unax4/Haptic-stimulation-and-drone-control/TFM_Guante_Haptico/main.tex

\documentclass[12pt]{article}
\usepackage[a4paper]{geometry}
\usepackage[dvipsnames]{xcolor}
\usepackage{lipsum}
\usepackage{framed}
\usepackage{graphicx}
\usepackage{afterpage}
\usepackage[spanish,es-nodecimaldot]{babel}
\usepackage[utf8]{inputenc}
\usepackage{titlesec}
\usepackage{colortbl}
\usepackage{xcolor}
\usepackage{cite}
\usepackage{booktabs}
\usepackage{tabularx}
\usepackage{enumerate}
\usepackage{multirow}
\usepackage{graphics}
\usepackage{appendix}
\usepackage{colortbl}
\definecolor{rowgray}{gray}{0.93}
\usepackage[nottoc]{tocbibind}
\addto\captionsspanish{
  \renewcommand{\refname}{Bibliografía}
}

\usepackage{tikz}
\usetikzlibrary{shapes,arrows}
\usepackage{caption}

\captionsetup{
  font=small,              % Tamaño pequeño, fuente LM Roman (por defecto)
  labelfont=bf,            % "Figura X." en negrita
  textfont=it,             % Descripción en cursiva (opcional)
  labelsep=period,         % Punto en lugar de dos puntos
  justification=centering,
  skip=0pt
}

\captionsetup[table]{
  name=Tabla,
  font=small,
  labelfont={bf},
  textfont=it,
  labelsep=period,
  justification=centering,
  position=top            % Captions de tablas arriba
}
\usepackage{subcaption}
\usepackage{amsmath,amsthm,amssymb,mathrsfs} 
\usepackage[final]{pdfpages}
\usepackage[]{placeins,flafter}
\usepackage[none]{hyphenat} \sloppy
\usepackage{xcolor}
\usepackage{adjustbox}
\geometry{top=2.5cm, bottom=2.5cm, left=2.5cm, right=2.5cm}
\usepackage[hidelinks]{hyperref}

% Configuramos el formato de la sección
\titleformat{\section}
  {\normalfont\Large\bfseries} % Estilo del texto
  {\thesection}                % Etiqueta (el número)
  {1em}                        % Espacio entre número y título
  {}                           % Código antes del título
  [{\titlerule[1.2pt]}]        % Código después: la línea (pegada al título)

\titlespacing*{\section}{0pt}{3.5ex plus 1ex minus .2ex}{2pc}

\newcommand{\sectionbreak}{\clearpage} % Requiere el paquete titlesec
\hypersetup{
    colorlinks=true,
    linkcolor=black,      % Color de enlaces internos
    citecolor=blue,       % Color de las citas ← AQUÍ
    filecolor=magenta,
    urlcolor=cyan,
}
\usepackage{chngcntr}
\counterwithin{figure}{section}
\counterwithin{table}{section}
\counterwithin{equation}{section}

\addto\captionsspanish{
  \renewcommand{\listfigurename}{Lista de Figuras}
  \renewcommand{\listtablename}{Lista de Tablas}
  \def\acknowledgmentsname{Agradecimientos}
}
% --- Configuración de Acrónimos ---
\usepackage[acronym, nomain, toc, section=section]{glossaries} 
\makeglossaries

% Definición acronimos
\newacronym{imu}{IMU}{Inertial Measurement Unit}
\newacronym{ble}{BLE}{Bluetooth Low Energy}
\newacronym{pcb}{PCB}{Printed Circuit Board}
\newacronym{tfg}{TFG}{Trabajo Fin de Grado}
\newacronym{adc}{ADC}{Analog to Digital Converter}
\newacronym{dac}{DAC}{Digital to Analog Converter}
\newacronym{lsb}{LSB}{Least Significant Byte}
\newacronym{udp}{UDP}{User Datagram Protocol}
\newacronym{spi}{SPI}{Serial Peripheral Interface}
\newacronym{sram}{SRAM}{Static Random-Access Memory}
\newacronym{fet}{FET}{Field-Effect Transistor}
\newacronym{bjt}{BJT}{Bipolar Junction Transistor}

\begin{document}
\definecolor{light-gray}{gray}{0.87}  

\begin{titlepage}

\vspace*{-4mm}
\begin{figure}[!h]
  \centering
	
\end{figure}

\vspace*{10mm}

\fontsize{28pt}{28pt}\selectfont
\begin{center}
\setlength{\fboxsep}{3.4mm}
\adjustbox{minipage=14.4cm,cfbox=black,center}{\begin{center} Trabajo Fin de Máster \end{center}}
\end{center}
\vspace*{5mm}

\fontsize{16pt}{16pt}\selectfont
\center{MASTER EN FÍSICA Y TECNOLOGÍAS FÍSICAS}

\vspace*{18.7mm}

\fontsize{20pt}{20pt}\selectfont
\begin{center}
\textbf{Sistema háptico basado en estimulación electrotáctil para captura de movimiento e interacción hombre-máquina }
\end{center}
\baselineskip 20pt

\vspace*{1cm} 
\baselineskip 36pt
\begin{center}
\fontsize{12pt}{12pt}\selectfont
\center{\rm  Autor}

\vspace*{1mm} 
\fontsize{18pt}{18pt}\selectfont
\center{Unax Arregi Ballestero}
\vspace*{1cm}
\baselineskip 36pt
\fontsize{12pt}{12pt}\selectfont
\center{\rm  Directores}
\vspace*{1mm}
\fontsize{14pt}{14pt}\selectfont
\center{Nicolás Medrado Marqués}
\center{Belén Calvo López}
\end{center}

\setcounter{footnote}{1}

\vspace*{26.45mm}
\fontsize{12pt}{12pt}\selectfont
\begin{center}
FACULTAD DE CIENCIAS\\
\vspace{3.5mm}
Departamento de Ingeniería Electronica y Comunicaciones\\
\vspace{3.5mm}
20 de Junio de 2026\\
\end{center}

\renewcommand{\thefootnote}{\arabic{footnote}}
\pagenumbering{gobble}
\end{titlepage}

\pagenumbering{roman}

\phantomsection
\addcontentsline{toc}{section}{\acknowledgmentsname}
\section*{\acknowledgmentsname} 

Gracias a la Agencia Estatal de Investigación, Ministerio de Ciencia e Innovación, con número de proyecto PID2022-138785OB-I00 (MCIN/AEI/10.13039/501100011033/FEDER, UE) por financiar los componentes necesarios para el desarrollo de este trabajo.

Asi mismo, gracias a mis directores del trabajo, Nicolás y Belén, por su apoyo, paciencia y guía durante todo el proceso de desarrollo de este trabajo. Y en especial, gracias a Oscar Lasarte por su indispensable ayuda en todo el montaje de la instrumentación y por todas las reparaciones que han sido necesarias a lo largo del proceso.

\listoffigures        % Índice de figuras
\listoftables         % Índice de tablas

\printglossary[type=\acronymtype, title={Lista de Acrónimos}]
\clearpage

%------------------ ÍNDICE ------------------
\newpage

\tableofcontents
\newpage

\pagenumbering{arabic}

%%%%%%%%%%%%%%%%%%%%%%%%%%%%%%%
%------------------ CONTENIDO ------------------
\section{Introducción}

La progresiva miniaturización de la electrónica y el aumento de la capacidad de procesamiento en sistemas embebidos han impulsado el desarrollo de nuevas formas de interacción entre humanos y dispositivos tecnológicos. En particular, las interfaces hápticas han cobrado especial relevancia en los últimos años, al permitir añadir el sentido del tacto como canal de comunicación con sistemas digitales, complementando los tradicionales estímulos visuales y auditivos. Esta tendencia resulta especialmente interesante en aplicaciones de realidad virtual, teleoperación y asistencia a la discapacidad.

Dentro de este marco, el presente Trabajo Fin de Máster se plantea como una continuación directa del Trabajo Fin de Grado llevado a cabo por Jorge Cuartero \cite{TFG}, en el que se abordó una primera aproximación al uso de sistemas vestibles para la captura del movimiento de la mano y su utilización como interfaz de control remoto mediante un \textit{dataglove}. A partir de esa base inicial, el objetivo actual consiste en avanzar hacia una integración más completa del sistema, incorporando un sistema háptico de estimulación electrotáctil y mejorando tanto el procesamiento embebido como la conectividad inalámbrica del dispositivo.

El núcleo del desarrollo se centra en construir un único guante vestible que sea capaz de combinar adquisición de movimiento, procesamiento local de datos y generación de sensaciones táctiles en la mano del usuario. Para ello se emplea un microcontrolador con capacidad de comunicación inalámbrica, una unidad de medida inercial (\gls{imu}) para la estimación de la orientación espacial y un sistema de estimulación eléctrica diseñado para generar sensaciones referidas en la zona palmar sin obstaculizar la manipulación natural de objetos. Así, se consigue mantener funcionalidad manual a la misma vez que se introduce un canal adicional de información sensorial.

El sistema resultante pretende servir como plataforma experimental para el estudio de interfaces hápticas portables y su aplicación a tareas de control e interacción virtual. La combinación de procesamiento embebido, adquisición sensorial y estimulación táctil en un único dispositivo portátil abre la puerta a interfaces más naturales, compactas y eficientes, donde parte del procesamiento se realiza localmente, reduciendo latencias y mejorando la autonomía del sistema.

A lo largo de la memoria, primeramente, se presenta el fundamento del sistema de estimulación electrotáctil y los criterios de diseño adoptados para lograr sensaciones localizadas en la mano. Después se describe el hardware del dispositivo, incluyendo el microcontrolador y demás electrónica necesaria. A continuación, se detalla el procesamiento de los datos de orientación y la integración de la información adquirida, junto con la caracterización experimental del sistema háptico. Finalmente, como aplicación del trabajo, se implementa el guante como un sustituto del mando de control de un dron, usando la comunicación inalámbrica brindada por el microcontrolador y empleando la parte háptica como un canal de información para conocer la telemetría del dron sin usar pantallas. Para concluir, se entabla una discusión de las limitaciones actuales y posibles líneas futuras de desarrollo.

\section{Generación de sensación táctil en la zona palmar de la mano}

Para poder crear sensación táctil en la mano, el objetivo es estimular los nervios que la atraviesan con una corriente determinada. Tanaka et al. \cite{Tanaka2023} diseñaron este sistema tratando de generar estas sensaciones en la zona palmar de la mano sin obstruir la misma, preservando así la destreza manual y la capacidad de interactuar con objetos físicos. Para lograrlo, se emplea una técnica basada en \textit{sensaciones referidas}, donde la estimulación eléctrica aplicada en una zona (el dorso de la mano) provoca percepciones somatosensoriales en una zona distal (la zona palmar).

A continuación, se describen los cinco desafíos técnicos identificados en la literatura analizada y las soluciones de diseño implementadas para alcanzar una estimulación precisa en 10 puntos de la zona palmar.

\paragraph{Desafío 1: Selección del punto de estimulación anatómica:} 

Aunque los nervios mediano y cubital recorren el antebrazo y la muñeca, la estimulación en estos puntos se ve limitada debido a que los nervios se encuentran agrupados o empaquetados. Esto impide la activación selectiva de dedos individuales sin generar interferencias entre ellos. 

Se optó por situar los electrodos en el dorso de la mano, ya que tras cruzar la muñeca, los nervios digitales se ramifican hacia cada dedo de forma independiente, haciendo posible un control individualizado de cada uno de ellos. Esta diferencia anatómica en la distribución de los nervios se ilustra en la Figura~\ref{fig:nervios_dorso}.

\paragraph{Desafío 2: Profundidad de penetración de la corriente}
Una disposición convencional de electrodos (ánodo y cátodo próximos sobre el dorso) resulta ineficaz, ya que la corriente fluye de forma superficial, estimulando solo los nervios dorsales. El principio físico aplicado aquí es que la profundidad de penetración de la corriente es proporcional a la distancia entre los electrodos. Para alcanzar los nervios palmares desde el dorso, se diseñó un sistema con una gran distancia inter-electrodo, permitiendo que la corriente atraviese de manera transversal el tejido de la mano. Esta elección de diseño se ilustra en la Figura~\ref{fig:nervios_dorso}.

\begin{figure}[htbp]
    \centering
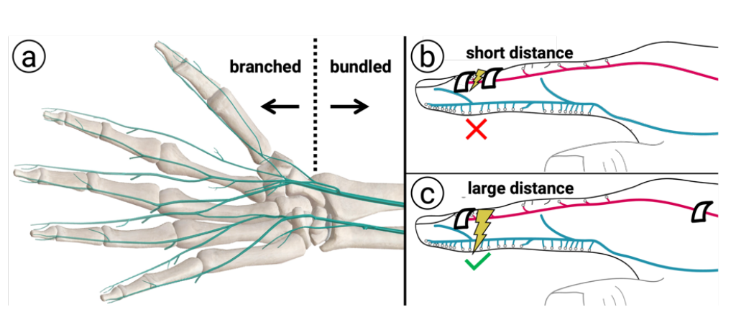
[picture p1: TFM_Guante_Haptico/Imagenes/nervios.png]
    
    \caption[Diferencia de agrupación nerviosa]{Ramificación en el dorso de la mano para la estimulación individual de dedos (a) y explicación esquemática de la elección de diseño de usar una distancia inter-electrodo grande (b y c). Adaptado de \cite{Tanaka2023}.}
    \label{fig:nervios_dorso}
\end{figure}

\paragraph{Desafío 3: Asimetría sensorial y umbrales de estimulación}
Según la teoría, la estimulación desde el dorso activa tanto la zona dorsal como la palmar, lo que generaría sensaciones confusas. Para resolver este conflicto, se aprovecha la diferencia entre número de neuronas que tienen las distintas partes de la mano: la zona palmar posee aproximadamente 18,000 mecanorreceptores, frente a solo 300 en la zona dorsal. 

Aprovechando esta diferencia, al calibrar la intensidad de la corriente, es posible superar el umbral de percepción palmar manteniéndose por debajo del umbral dorsal, haciendo que la sensación en la palma sea la única percibida por el usuario (ver Figura~\ref{fig:umbrales_sensibilidad}).

\paragraph{Desafío 4: Focalización de la sensación y polaridad}
Se observó que los electrodos situados en el dorso de los dedos generan sensaciones desplazadas (\textit{offset}) respecto a la ubicación deseada en la palma; específicamente, no lograban estimular las falanges distales. 

La solución implementada consistió en invertir la polaridad. Mientras que la estimulación anódica es el estándar, se implementó estimulación catódica para los electrodos de las falanges distales. Asi, se podría adelantar la ubicación de la sensación hacia la punta de los dedos, permitiendo la estimulación del pulpejo desde el dorso.

\begin{figure}[htbp]
    \centering
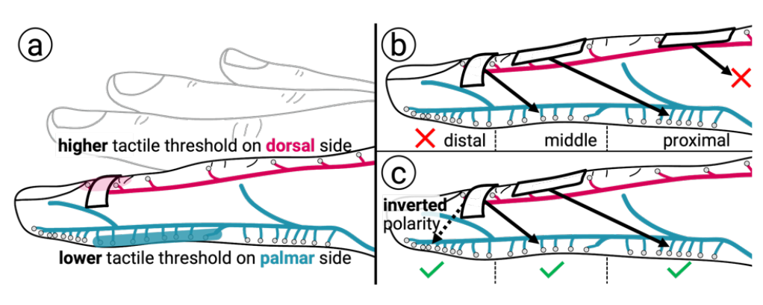
[picture p2: TFM_Guante_Haptico/Imagenes/umbrales.png]
    
    \caption[Asimetría de umbrales en la mano]{(a) El umbral táctil para la estimulación eléctrica es significativamente más bajo en el lado palmar que en el lado dorsal. (b, c) El uso de ambas polaridades (anódica y catódica) para el electrodo fijado a la punta del dedo permite la estimulación del pulpejo.}
    \label{fig:umbrales_sensibilidad}
\end{figure}

\paragraph{Desafío 5: Mitigación de interferencias inter-digitales}
Debido a que el nervio mediano inerva los dedos pulgar, índice y medio, mientras que el nervio cubital (ulnar) inerva el anular y meñique, el uso de un único electrodo de tierra general provocaba sensaciones referidas no deseadas en dedos adyacentes. 

El diseño final soluciona este problema mediante el uso de dos electrodos de tierra independientes, uno para cada nervio. Al conmutar el flujo de corriente hacia la tierra correspondiente según el dedo objetivo, se logra una selectividad total, resultando en un sistema capaz de generar sensaciones en un total de 10 electrodos colocados en la mano (más los dos de tierra) sin obstrucción palmar alguna, tal como se detalla en el esquema de la Figura~\ref{fig:disposicion_electrodos}.

\begin{figure}[htbp]
    \centering
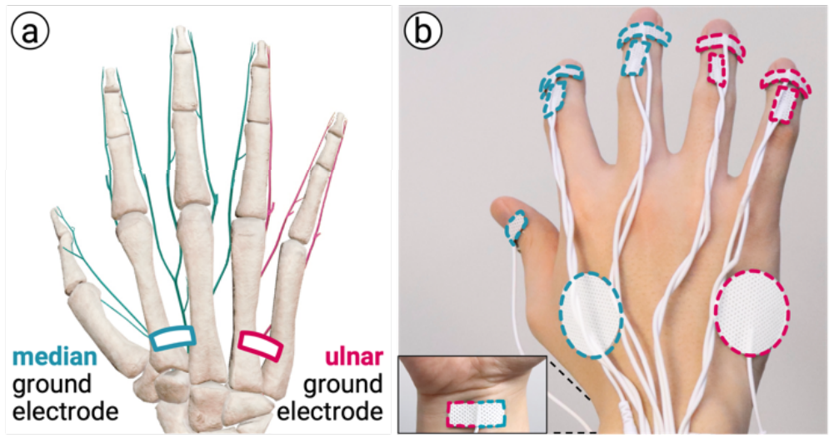
[picture p3: TFM_Guante_Haptico/Imagenes/disposicionfinal.png]
    
    \caption[Configuración final del sistema háptico]{Configuración final de electrodos con doble toma de tierra para evitar interferencias entre los nervios mediano y cubital. Adaptado de \cite{Tanaka2023}.}
    \label{fig:disposicion_electrodos}
\end{figure}

\section{Interfaz hardware}

El sistema completo para poder llevar a cabo el objetivo propuesto se monta en un guante, que se muestra en la Figura \ref{fig:montaje_completo}. Se distinguen los siguientes componentes: en cada dedo, del anular al meñique, sujetas por unas pequeñas piezas, fijamos bandas piezorresistivas que nos permitirán determinar su flexión. En la parte inferior se encuentra la \gls{pcb}, capaz generar corrientes controladas por voltaje y programadas mediante un potenciometro digital. En la parte inferior de la placa, se encuentran los conectores hembra donde se introducen los electrodos conectados a la mano. La información proporcionada por las bandas se introduce en un Raspberry RP2040 Connect, alojado en una caja central fijada a la muñeca. A la misma vez, este dispositivo se encarga de la generación de señales eléctricas que pasan por la \gls{pcb}.

\begin{figure}[htbp]
    \centering
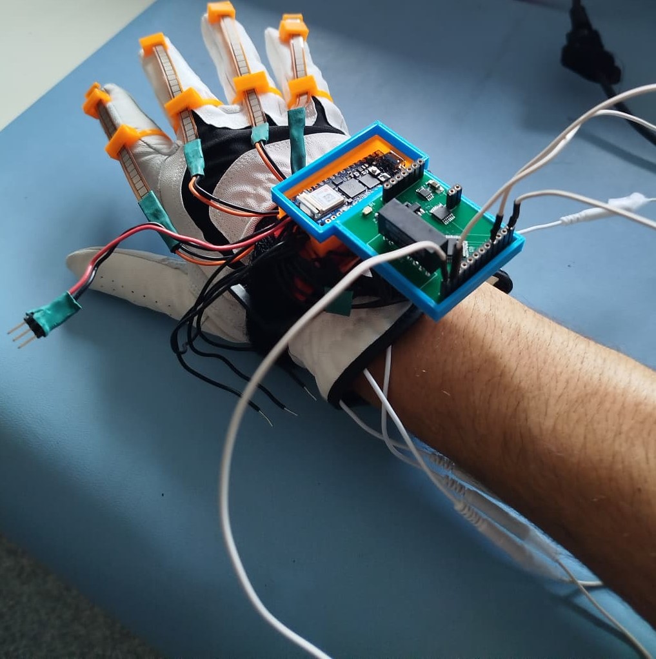
[picture p4: TFM_Guante_Haptico/Imagenes/montaje_completo.jpeg]
    
    \caption[Montaje final del sistema háptico]{Montaje final del sistema háptico y de captura de movimiento}
    \label{fig:montaje_completo}
\end{figure}

\subsection{Arduino Nano RP2040 Connect}
El microcontrolador usado para el trabajo será un módulo Arduino RP2040 Connect \cite{Arduino2040}, que incorpora un microcontrolador Raspberry Pi Pic. Este controlador proporciona una gran potencia de cálculo, un factor que será relevante en el procesamiento de datos que se llevará a cabo para la estimación de la orientación. Además tiene un modulo Wifi, que se usará para la comunicación en la interfaz de control en la sección \ref{sec:dron}.

En cuanto a las especificaciones generales, el RP2040 Connect opera a 3.3 V. Consta de un microcontrolador Raspberry Pi Pico (133 MHz de reloj, 256 kB de memoria \gls{sram}) con 8 entradas analógicas (configuradas como convertidores analógico-digitales o  \gls{adc}, de las que 4 estarían destinadas a la adquisición de las posiciones de los dedos. Cuenta además con una \gls{imu} de 6 ejes, modelo LSM6DSOXTR \cite{LSM6DSOX}.
\

\subsubsection{Módulo LSM6DSOXTR}

Este módulo \cite{LSM6DSOX} consta de un acelerómetro y un giróscopo, proporcionando así información de 6 ejes (3 de aceleración y 3 de rotación espacial). Aunque ambos pueden operar a distintos fondos de escala y resoluciones, la librería utilizada (Arduino\_LSM6DSOX \cite{LibreriaLSM6DSOX}) viene configurada con una sensibilidad de 0.122 mg/LSB (siendo g la aceleración de la gravedad y \gls{lsb} el bit menos significativo) para el acelerómetro y una sensibilidad de 0.07 dps/LSB para el giróscopo (donde dps son Degrees per second, grados por segundo), valores adecuados para nuestra aplicación
(menores que el propio ruido). Esta librería dispone de dos funciones, una encargada de devolver 3 valores en representación de punto flotante para los tres ejes de la aceleración, y la otra de devolver los 3 valores referentes a la velocidad de rotación en cada eje en el mismo formato.

La frecuencia de medida está fijada en 104 Hz de manera predeterminada por la librería LSM6DSOX. Aunque una alta frecuencia de muestreo era importante para la estimación de la orientación mediante integración del giroscopio \cite{TFG}, para el método que se utilizará en este trabajo con esta tasa de muestreo se obtendrá un resultado que no se verá limitado por este valor. De todos modos, con esta configuración un ciclo de medida y procesado de nuestro Arduino no podrá durar más de 10  para que no se solapen medidas de la \gls{imu}, forzando a optimizar los tiempos de cada parte del procesado.

\subsubsection{Módulo de conectividad inalámbrica NINA-W102}

La comunicación inalámbrica del guante se implementa a través del módulo u-blox NINA-W102 \cite{NINA-W102}, integrado directamente en la placa Arduino Nano RP2040 Connect. Su arquitectura interna aloja un microprocesador de doble núcleo ESP32 dedicado en exclusiva a la gestión de la pila de protocolos de red, lo que descarga completamente al procesador principal RP2040 de esta tarea y preserva su capacidad de cómputo para el procesamiento de la \gls{imu}, la lógica de control y el sistema háptico.

El módulo soporta tanto \gls{ble} como Wi-Fi (802.11 b/g/n a 2.4~GHz). Para este diseño se ha optado por Wi-Fi, ya que el volumen de datos a transmitir y el procesamiento extra del sistema, exige un ancho de banda que \gls{ble} no puede garantizar sin introducir retardos en el lazo de control con el entorno virtual, a parte de qué usar Wi-Fi será imprescindible debido a las caracteristicas del dron que se operará en la sección \ref{sec:dron}.

\subsection{Sistema de adquisición de posiciones de la mano}
El sistema de determinación de la flexión de los dedos se basa en las bandas piezorresistivas antes mencionadas. Una piezorresistencia es un material o componente que, bajo un esfuerzo mecánico, sufre un cambio en su resistividad. En nuestro caso se usarán los Flex Sensor de Spectra Symbol \cite{Flex-Sensor}, caracterizados por valores nominales entre $7\,\mathrm{k\Omega}$ y $13\,\mathrm{k\Omega}$ en reposo, de forma que al ser dobladas, como mínimo duplican su valor resistivo. Como el Arduino no puede medir directamente resistencias, en \cite{TFG} se implementó un circuito auxiliar que permite traducir estos cambios en tensión.

Este circuito consiste en un divisor resistivo formado por una resistencia fija ($R_{\text{fija}}$) en serie con el elemento piezorresistivo ($R_{\text{piezo}}$), alimentado a los 3.3~V proporcionados por el propio microcontrolador. De este modo, las variaciones de resistencia de los sensores se transforman en variaciones de voltaje según la relación:

\begin{equation}
V_{\text{divisor}}(R_{\text{piezo}}) = 3.3 \cdot \frac{R_{\text{fija}}}{R_{\text{piezo}} + R_{\text{fija}}}
\end{equation}

Para maximizar el rango de oscilación de la tensión de salida y optimizar la precisión de la lectura, el valor de $R_{\text{fija}}$ se calcula para cada sensor mediante la media geométrica de sus extremos resistivos:

\begin{equation}
R_{\text{fija}} = \sqrt{R_{\text{max}} \cdot R_{\text{min}}}
\end{equation}

donde $R_{\text{max}}$ y $R_{\text{min}}$ representan las resistencias máxima y mínima medidas en flexión (pico) y extensión (relajado), respectivamente. En el montaje real, se seleccionan los valores comerciales de resistencia fija más cercanos a los óptimos teóricos calculados para el rango de cada dedo. El cálculo con los valores que finalmente se usan en el \textit{dataglove} se detallan en el anexo de \cite{TFG}.

La tensión de salida del divisor se introduce en los pines analógicos del microcontrolador, configurados como entradas del \gls{adc}. Este convertidor opera con una resolución de 10 bits (lo que genera un rango digital de 0 a 1023 cuentas) y un rango de tensión de 0 a 3.3~V, lo que resulta en una resolución de medida de 3.2~mV. Además, el tiempo de adquisición es inferior a 30~$\mu$s, lo que cumple holgadamente con los requisitos de velocidad y tasa de muestreo exigidos para completar un ciclo de nuestro proceso.

\subsection{Circuito de estimulación electrotáctil}

Para poder conseguir estimular los nervios de la mano y generar sensación táctil, según la bibliografía existente en el ámbito \cite{Tanaka2023}, la corriente generada debe ser del orden de pocos miliamperios y, al mismo tiempo, de suficiente tensión como para superar la impedancia de la piel, que según medidas rápidas tomadas en el laboratorio esta en torno al megaohmio. 

Además, según el sistema de electrodos descrito en la sección 2, debe poder conmutar entre 10 canales de estimulación y cambiar entre corriente catódica y anódica según lo requiera la configuración correspondiente, por lo que teniendo todo esto en cuenta el circuito finalmente construido será el de la Figura \ref{fig:circuito_estimulacion}:

\begin{figure}[htbp]
    \centering
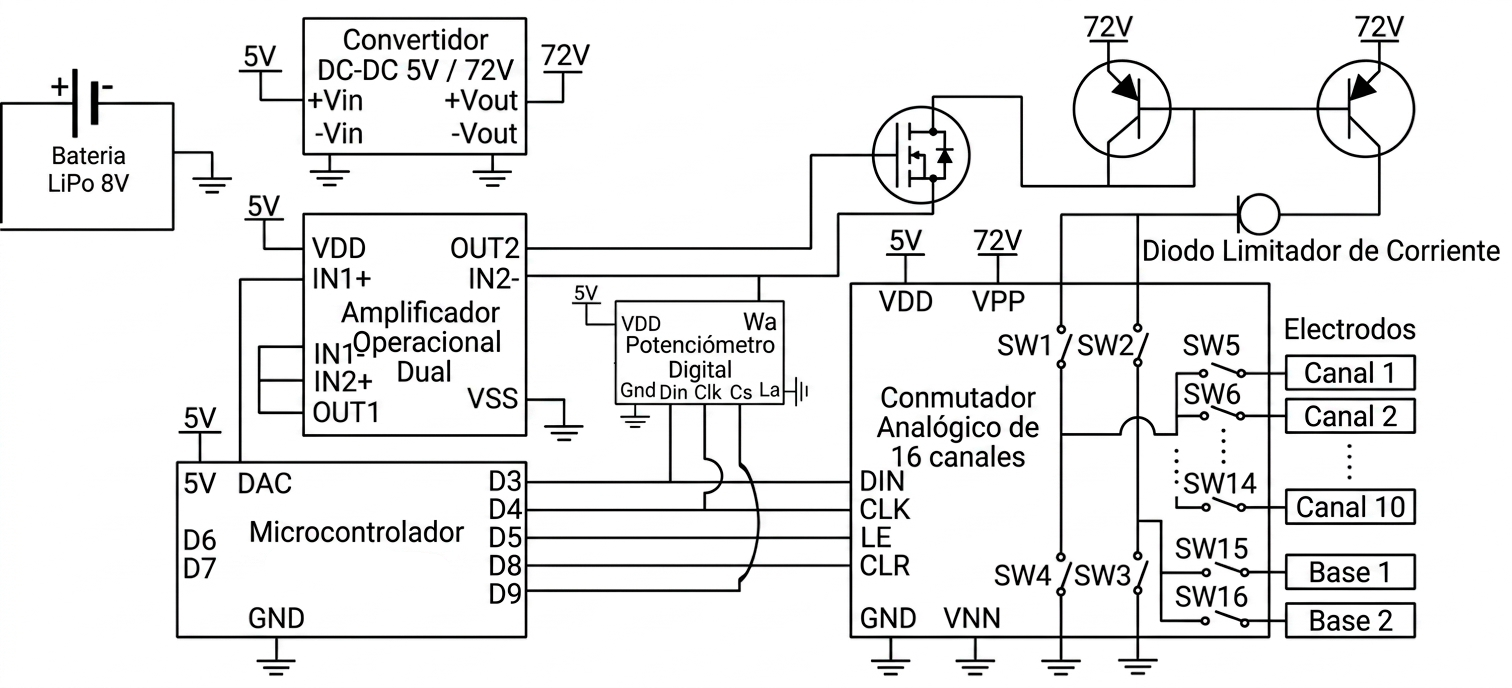
[picture p5: TFM_Guante_Haptico/Imagenes/Circuito_estimulacion.png]
     % Ajusta el nombre y escala
    \caption{Esquema del circuito de estimulación electrotáctil diseñado para el guante.}
    \label{fig:circuito_estimulacion}
\end{figure}

Así, este circuito se alimenta directamente a través de la batería de 7.4~V con una capacidad de almacenamiento de energía de 1000 mAh conectada al pin $V_{\text{in}}$ del Arduino Nano RP2040 Connect, colocando en el cable que sale a alimentar el sistema un regulador a 5 V constantes. Para la etapa de estimulación, la generación de la alta tensión de 72~V se confía a un convertidor DC-DC modelo NMT0572SC, el cual se alimenta con esta salida regulada de 5~V.

Como este microcontrolador no tiene una salida \gls{dac}, para controlar de manera precisa la intensidad de los impulsos electrotáctiles y adaptarla a los umbrales sensitivos del usuario, se ha sustituido el potenciómetro analógico manual por un potenciómetro digital MAX5413. El microcontrolador gobierna este dispositivo mediante un protocolo basado en \gls{spi}, optimizando el uso de pines al compartir las líneas de datos DIN y de reloj CLK con el circuito integrado de conmutación de alta tensión HV2701, requiriendo únicamente una línea adicional para la selección de chip el potenciometro (CS*). La señal digital del microcontrolador se hace pasar por este potenciómetro y se introduce en un amplificador operacional LMV341 conectado a un \gls{fet} BSS87, configurando una fuente de corriente controlada por voltaje para independizar la señal de la carga. Acto seguido, un espejo de corriente basado en transistores bipolares \gls{bjt} FCX705 replica esta corriente de referencia y la transfiere hacia la línea de alta tensión de 72~V, asegurando un flujo eléctrico constante.

La señal de corriente regulada por esta etapa se inyecta en el conmutador analógico de alta tensión HV2701. Este circuito integrado multiplexa la señal hacia los 10 canales disponibles en la mano y las dos tomas de tierra independientes (Base 1 y Base 2), encargadas de aislar los nervios mediano y cubital. Internamente, una matriz de interruptores actúa a modo de puente en H para invertir dinámicamente la polaridad de la estimulación (catódica o anódica) según los requerimientos específicos de la zona palmar seleccionada.

Debido a la arquitectura del sistema, el integrado HV2701 solo puede habilitar un camino de corriente hacia un único objetivo simultáneamente. Por ello, la simultaneidad perceptiva no se implementa manteniendo varios caminos activos a la vez, sino serializando los pulsos en el firmware: cada estímulo se aplica sobre una única ruta, que se abre y se cierra explícitamente antes de pasar a la siguiente. Dado que este integrado es capaz de conmutar entre canales en un tiempo de apenas 10~$\mu$s \cite{HV2701_DataSheet}, esta secuenciación cabe holgadamente dentro del tiempo de bucle de 10~ms.

Para dotar de seguridad al sistema y evitar accidentes se integra en serie un diodo limitador de corriente (E-452) que actúa como limitador físico si la corriente de salida llega a alcanzar los 4.5~mA, garantizando la inocuidad del guante ante cualquier fallo de ejecución en el microcontrolador. Por último, todo este diseño electrónico se ha plasmado en una \gls{pcb} que fue diseñada mediante el software KiCad y posteriormente enviada a fabricar para su ensamblaje final, diseño y resultado que se pueden ver en la Figura \ref{fig:diseno_pcb}.

\begin{figure}[htbp]
    \centering
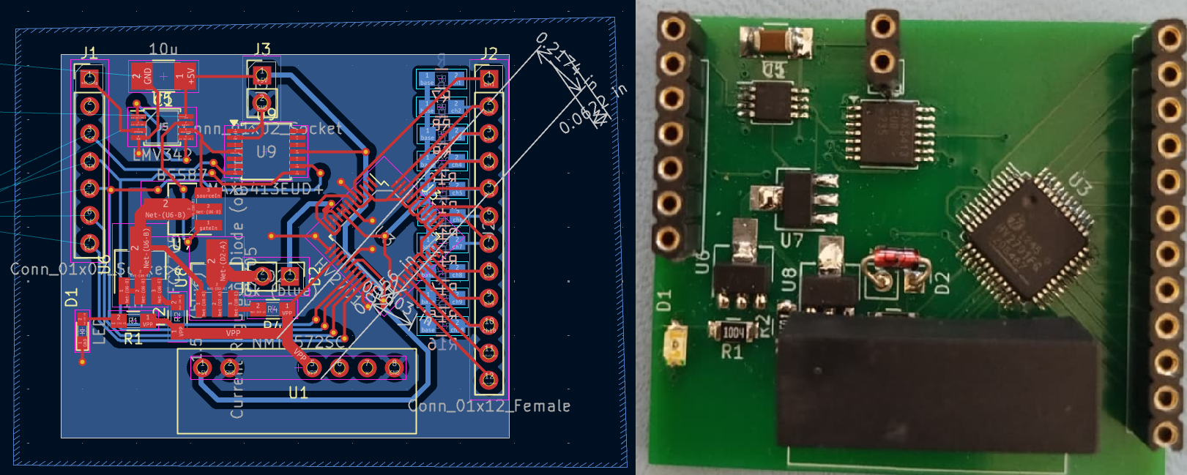
[picture p6: TFM_Guante_Haptico/Imagenes/diseño_pcb.png]
     % Ajusta el nombre de la imagen y escala
    \caption[Diseño final de la \gls{pcb} del circuito de estimulación electrotáctil]{Diseño final de la \gls{pcb} del circuito de estimulación electrotáctil desarrollado en KiCad y resultado final una vez se recibió de la fábrica. Agradecimientos a Diego Antolín por su ayuda con el diseño y a Óscar Lasarte por montar la placa.}
    \label{fig:diseno_pcb}
\end{figure}

\section{Procesamiento de datos: orientación espacial}
El núcleo del procesamiento de datos de la \gls{imu} LSM6DSOXTR reside en la estimación precisa de la orientación del sensor. Anteriormente, se planteaba el sistema de ecuaciones para obtener la expresión de los ángulos de Euler de la orientación, pero haciendo esto, una de las ecuaciones debe de integrar en el tiempo dos de los ejes del giroscopio. Con este método el procesamiento inducia en deriva de uno de los ángulos de manera inevitable \cite{TFG}.

Para este trabajo, se ha implementado un filtro algoritmico propuesto por Mahony et al. \cite{Mahony2008}, el cual formula el problema de estimación como una cinemática de observador determinista directamente sobre el grupo ortogonal especial $SO(3)$. Este método utiliza la geometría del grupo de Lie para desacoplar las mediciones del giroscopio del error de actitud reconstruido, buscando una implementación lo más eficiente posible para el hardware disponible.

\subsection{Representación de la orientación: cuaterniones}

Antes de formular el filtro, es necesario elegir cómo representar matemáticamente la orientación del sensor en el espacio tridimensional. La opción más intuitiva son los ya mencionados ángulos de Euler: guiñada $\psi$ (\textit{yaw}), cabeceo $\theta$ (\textit{pitch}) y alabeo $\phi$ (\textit{roll}). Estos presentan una singularidad
conocida como \textit{gimbal lock} cuando dos ejes de rotación se alinean, además de requerir funciones trigonométricas computacionalmente costosas para el RP2040.
Por ello, el filtro opera internamente con cuaterniones unitarios, una representación algebraica que evita estas singularidades y permite actualizar la orientación mediante operaciones aritméticas simples.

Un cuaternión unitario $\mathbf{q}$ queda definido como:

\begin{equation}
\mathbf{q} =
\begin{pmatrix}
q_0 \\ q_1 \\ q_2 \\ q_3
\end{pmatrix},
\qquad \|\mathbf{q}\|=1,
\end{equation}

donde $q_0$ es la parte escalar, asociada al ángulo de rotación, y
$(q_1, q_2, q_3)$ es la parte vectorial, asociada al eje de rotación. La condición de unitariedad garantiza que el cuaternión represente siempre una rotación pura, sin escalado. Cuando se requiere expresar la orientación final en ángulos de Euler para enviarlos al entorno de control, la conversión se realiza a posteriori, de forma que todo el procesamiento interno permanece libre de singularidades.

\subsection{Fusión de acelerómetro y giroscopio}

El giroscopio proporciona la velocidad angular $\boldsymbol{\omega}$, que integrada en el tiempo permite seguir la evolución de la orientación con gran precisión a corto plazo.
Sin embargo, cualquier sesgo (\textit{bias}) estático o deriva lenta en sus lecturas se acumula en la integral, generando un error de orientación que crece sin límite con el tiempo. El acelerómetro, por su parte, mide la aceleración total del sensor; cuando el guante no está sometido a aceleraciones externas apreciables, esta medida queda dominada por la gravedad terrestre, cuya dirección es conocida en el marco inercial. Esto permite obtener una referencia absoluta de inclinación, libre de deriva, aunque ruidosa en presencia de movimientos bruscos.

El filtro de Mahony se basa en la complementariedad de ambos sensores: el giroscopio proporciona una estimación dinámica y precisa a corto plazo, mientras que el acelerómetro corrige continuamente la deriva a largo plazo. Para cuantificar cuánto difiere la orientación estimada de la real se define un error vectorial $\mathbf{e}$ mediante el producto vectorial entre la dirección de la gravedad medida por el acelerómetro normalizada y la dirección de la gravedad que el cuaternión actual predice en el marco del sensor \cite{Mahony2008}:

\begin{equation}
\mathbf{e} = \hat{\mathbf{a}} \times \mathbf{v},
\end{equation}

donde $\hat{\mathbf{a}} = \mathbf{a}/\|\mathbf{a}\|$ es la aceleración normalizada y $\mathbf{v}$ es la estimación de la dirección de la gravedad obtenida rotando el vector $[0,0,1]^T$ con el cuaternión actual:

\begin{equation}
\mathbf{v} =
\begin{pmatrix}
2(q_1 q_3 - q_0 q_2) \\
2(q_0 q_1 + q_2 q_3) \\
q_0^2 - q_1^2 - q_2^2 + q_3^2
\end{pmatrix}.
\end{equation}

El producto vectorial produce un vector cuya dirección es el eje en torno al cual debe corregirse la estimación y cuya magnitud es proporcional al ángulo de error. Cuando ambos vectores coinciden, el error es nulo y el filtro no introduce ninguna corrección. Por lo tanto, esta formulación evita la reconstrucción algebraica completa de la actitud, ya que el error se calcula directamente en el espacio del sensor sin pasar por ángulos de Euler.

\subsection{Controlador PI y corrección del bias}

El error $\mathbf{e}$ se utiliza para corregir la velocidad angular antes de integrarla, mediante un controlador proporcional-integral (PI) clásico. La acción proporcional, escalada por la ganancia $K_p$, reacciona inmediatamente al error presente; la acción integral, escalada por $K_i$, acumula el error a lo largo del tiempo y compensa el sesgo estático del giroscopio:

\begin{equation}
\mathbf{e}_{\text{int}}(t) = \mathbf{e}_{\text{int}}(t - \Delta t) + K_i \, \mathbf{e} \, \Delta t,
\end{equation}

\begin{equation}
\boldsymbol{\omega}_c = \boldsymbol{\omega} + K_p \mathbf{e} + \mathbf{e}_{\text{int}}.
\end{equation}

La velocidad angular corregida $\boldsymbol{\omega}_c$ se usa para propagar el cuaternión en el tiempo. La cinemática diferencial del cuaternión unitario establece que:

\begin{equation}
\dot{\mathbf{q}} = \frac{1}{2} \, \mathbf{q} \otimes
\begin{pmatrix} 0 \\ \boldsymbol{\omega}_c \end{pmatrix},
\end{equation}

donde $\otimes$ denota el producto de cuaterniones. Discretizando mediante integración de Euler con paso $\Delta t$:

\begin{equation}
\mathbf{q}_{k+1} = \mathbf{q}_k + \frac{1}{2} \, \mathbf{q}_k \otimes
(0, \boldsymbol{\omega}_c) \, \Delta t,
\end{equation}

lo que, expandido en sus cuatro componentes, resulta en:

\begin{equation}
\begin{aligned}
q_0 &\leftarrow q_0 - \tfrac{\Delta t}{2}(q_1 g_x + q_2 g_y + q_3 g_z), \\
q_1 &\leftarrow q_1 + \tfrac{\Delta t}{2}(q_0 g_x + q_2 g_z - q_3 g_y), \\
q_2 &\leftarrow q_2 + \tfrac{\Delta t}{2}(q_0 g_y - q_1 g_z + q_3 g_x), \\
q_3 &\leftarrow q_3 + \tfrac{\Delta t}{2}(q_0 g_z + q_1 g_y - q_2 g_x),
\end{aligned}
\end{equation}

donde $(g_x, g_y, g_z)$ son las componentes de $\boldsymbol{\omega}_c$. Estas operaciones son básicamente sumas y multiplicaciones de enteros en punto flotante, sin funciones trigonométricas, lo que hace al algoritmo sea adecuado para el RP2040. Tras cada iteración, el cuaternión se renormaliza para mantener la condición de unitariedad y evitar la acumulación de errores numéricos:

\begin{equation}
\mathbf{q} \leftarrow \frac{\mathbf{q}}{\|\mathbf{q}\|}.
\end{equation}

La estabilidad de este esquema de corrección fue demostrada por Mahony et al. \cite{Mahony2008} mediante un análisis de Lyapunov. Utilizando como función candidata la traza de la matriz de error de orientación y el módulo del bias estimado, se prueba que su derivada temporal es semidefinida negativa, lo que garantiza la convergencia
casi global del error de orientación a cero y del bias estimado hacia su valor real.

\subsection{Calibración inicial y recentrado dinámico}

Al encender el guante, antes de comenzar la estimación en régimen permanente, se realiza una fase de calibración en la que el sistema se mantiene en reposo durante la adquisición de $N = 100$ muestras de velocidad angular. El bias inicial del giroscopio se estima como la media de dichas muestras:

\begin{equation}
\mathbf{b}_\omega = \frac{1}{N} \sum_{i=1}^{N} \boldsymbol{\omega}_i,
\end{equation}

y a partir de ese instante, toda medida angular se corrige sustrayendo este valor antes de introducirlo en el filtro. Esta calibración reduce el error inicial del controlador
integral, acelerando la convergencia del filtro.

Además del sesgo del giroscopio, existe un segundo problema a tener en cuenta: la orientación física del guante en el momento de encendido puede ser arbitraria, lo que haría que la estimación de la orientación comenzara desde una postura diferente. Para resolverlo, una vez completada la calibración se captura el cuaternión resultante como referencia de postura neutra, calculando su conjugado:

\begin{equation}
\mathbf{q}_{\text{off}} = (q_0, -q_1, -q_2, -q_3).
\end{equation}

A partir de ese momento, la orientación transmitida al entorno de control no es $\mathbf{q}$ sino la orientación relativa al instante de referencia, obtenida mediante el producto:

\begin{equation}
\mathbf{q}_{\text{rel}} = \mathbf{q}_{\text{off}} \otimes \mathbf{q}.
\end{equation}

Este recentrado garantiza que el sistema arranque siempre en una postura neutra definida por el usuario, independientemente de la orientación física inicial del guante, simplificando la puesta en marcha y haciendo el dispositivo robusto frente a variaciones en la colocación del guante entre sesiones. Además, durante el uso del guante, el usuario puede accionar el reseteo de la referencia en cualquier momento, lo que permite adaptar dinámicamente el sistema a cambios en la postura del brazo o a la necesidad de reajustar la posición neutra durante una sesión prolongada.

\section{Procesamiento de datos: flexión de los dedos}

A diferencia del bloque anterior, orientado al tratamiento de los datos de la \gls{imu}, este apartado describe el procesamiento de la información procedente de los divisores piezorresistivos para la determinación de la posición de los dedos. Como se adelantó en la introducción, esta tarea se delega en un módulo de inteligencia artificial embebido, ya que aunque sería factible establecer umbrales fijos para cada posición, las herramientas actuales de despliegue de modelos neuronales sobre microcontroladores ofrecen soluciones más flexibles, robustas frente a la variabilidad entre sesiones y computacionalmente ligeras.

Una red neuronal es un conjunto de nodos interconectados que, al recibir una serie de valores de entrada, los transforma a través de sucesivas capas de procesamiento hasta producir una salida. El interés de estas redes reside en su capacidad de ajustar los pesos de sus conexiones durante un proceso de entrenamiento, en el que se le presentan ejemplos etiquetados y la red modifica iterativamente sus parámetros para minimizar el error entre su salida y la respuesta esperada. Para el reconocimiento de posiciones de la mano, se emplea una arquitectura \textit{fully connected}, en la que todos los nodos de una capa conectan con todos los nodos de la siguiente, tal como se ilustra en la Figura~\ref{fig:red_fc}.

\begin{figure}[htbp]
    \centering
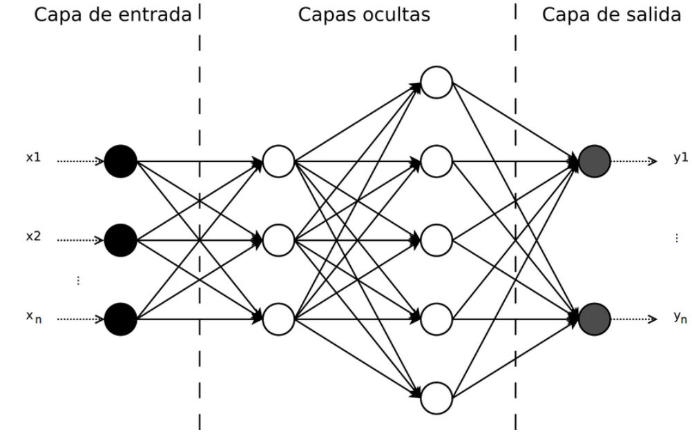
[picture p7: TFM_Guante_Haptico/Imagenes/fully_conected.png]
    
    \caption[Arquitectura de red neuronal \textit{fully connected}]{Esquema de una red
    neuronal \textit{fully connected} \cite{TFG}.}
    \label{fig:red_fc}
\end{figure}

La selección inicial de la arquitectura se lleva a cabo en Python mediante \textit{scikit-learn}, usando una red \textit{fully connected} de tipo \texttt{MLPClassifier}. Posteriormente, una vez fijada la configuración, el modelo equivalente se entrena y exporta con TensorFlow Lite \cite{TensorFlow} para su integración en el microcontrolador. Aun así, antes de definir la arquitectura de la red hay que recopilar una serie de datos que formarán el conjunto de entrenamiento.

\subsection{Dataset}

El \textit{dataset} es el conjunto de ejemplos etiquetados a partir del cual la red aprende a asociar cada combinación de lecturas sensoriales con la posición correcta de la mano. En este trabajo, las entradas de la red son los dos valores del \gls{adc} correspondientes a los dedos índice y corazón, únicos sensores piezorresistivos destinados al reconocimiento de postura. Los dedos anular y meñique se reservan para funciones de control independientes descritas en la sección~\ref{sec:dron}, por lo que sus lecturas no forman parte del clasificador.

La salida de la red es un identificador de posición codificado como un entero entre 0 y 8, correspondiente a las 9 posiciones representadas en la Figura~\ref{fig:posiciones_dataset}. Esta reducción respecto al trabajo previo, donde se usaban cuatro dedos \cite{TFG}, podría suponer una limitación, pero en ciertos aspectos aporta ventajas sobre la red neuronal: con solo dos entradas, el espacio de estados que la red debe aprender se reduce a la mitad, lo que permite alcanzar precisiones elevadas con arquitecturas más pequeñas, menor tiempo de inferencia en el microcontrolador y menor riesgo de sobreajuste durante el entrenamiento. Además, al disponer de un número de clases ligeramente menor (9 frente a 10), el problema de clasificación resulta intrínsecamente más sencillo, especialmente porque se eliminan algunas de las posiciones más similares entre sí que generan mayor confusión en la red.

\begin{figure}[htbp]
    \centering
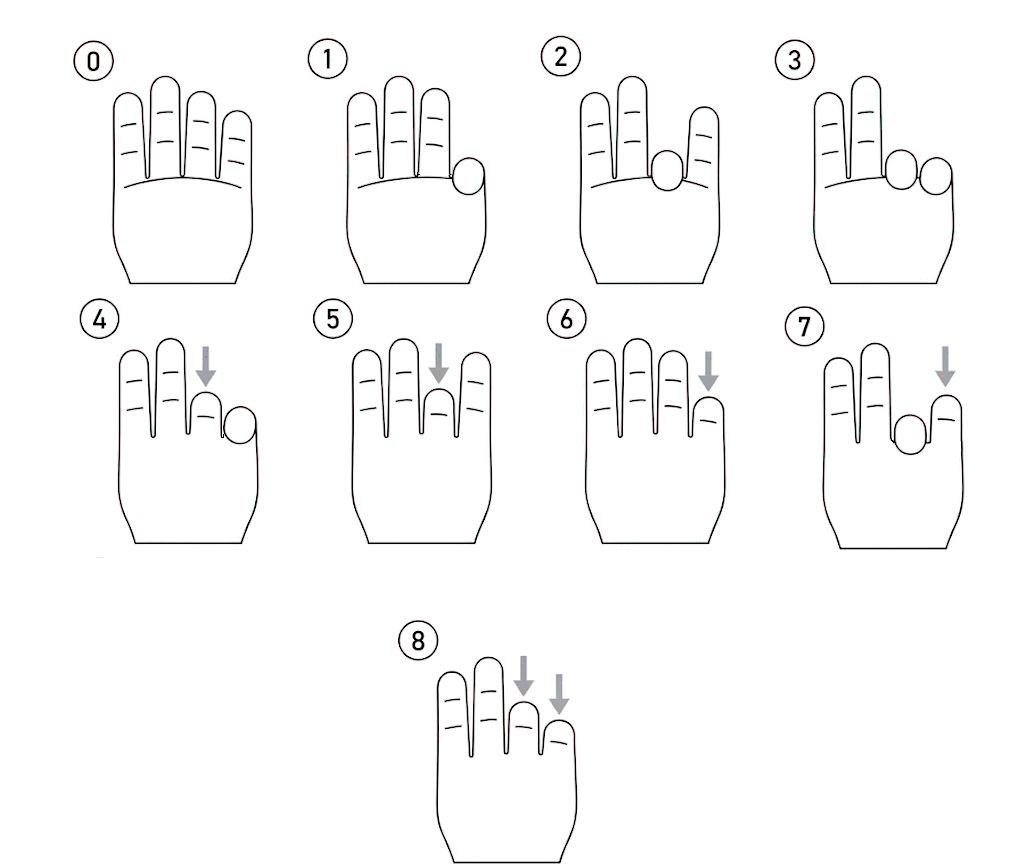
[picture p8: TFM_Guante_Haptico/Imagenes/DATASET.png]
    
    \caption[Posiciones definidas para el \textit{dataset}]{Representación de las 9
    posiciones definidas para el \textit{dataset}.}
    \label{fig:posiciones_dataset}
\end{figure}

Para la adquisición de los datos se desarrolló un programa que, cada vez que se pulsa \textit{enter}, solicita al usuario que adopte una de las posiciones indicadas y almacena las lecturas de los sensores en un fichero de texto. Con el fin de dotar a la red de la mayor robustez posible frente a variaciones en la colocación del guante o en las condiciones de uso, el \textit{dataset} se tomó a lo largo de varios días distintos, introduciendo así dispersión natural debida a ligeras diferencias en la posición del guante sobre la mano o en la postura del brazo.

El conjunto de datos resultante cuenta con 460 muestras, con entre 50 y 54 ejemplos por posición, distribuidas de forma uniforme entre las 9 clases para evitar sesgos durante el entrenamiento, como puede comprobarse en la Figura~\ref{fig:histograma_dataset}. En la Figura~\ref{fig:boxplot_dataset} se muestran los gráficos de cajas y bigotes para cada posición, que muestran la variabilidad de las lecturas del \gls{adc} en cada clase y la existencia de solapamientos entre algunas posiciones, lo que justifica la necesidad de un clasificador no lineal como la red neuronal para resolver estas ambigüedades.
En cuanto al reparto empleado durante la selección de la arquitectura, el 80\,\% de los datos se destinan al entrenamiento y validación cruzada, y el 20\,\% restante se reserva como conjunto de test, seleccionados de forma aleatoria estratificada.

\begin{figure}[htbp]
    \centering
    
    \caption[Distribución del \textit{dataset} por posición]{Histograma del número de
    muestras por posición en el \textit{dataset}.}
    \label{fig:histograma_dataset}
\end{figure}

\begin{figure}[htbp]
    \centering
    
    \caption[Distribución de valores ADC por posición]{Gráficos de cajas y bigotes que
    muestran la distribución de los valores del \gls{adc} para cada dedo en cada
    posición del \textit{dataset}.}
    \label{fig:boxplot_dataset}
\end{figure}

Por conveniencia, los valores del \textit{dataset} se escalan acotando todas las lecturas entre 0 y 1 respecto a los extremos registrados durante una calibración previa.
Esta normalización garantiza que, aunque existan ligeras variaciones en el funcionamiento de los sensores entre sesiones o diferencias en la colocación del guante, el clasificador opere siempre sobre el mismo rango de entrada, preservando su precisión
en el uso cotidiano.

\subsubsection{Codificación de salida}

Dado que se trata de un problema de clasificación multiclase, cada muestra del \textit{dataset} se etiqueta con un entero entre 0 y 8. Durante la selección de la arquitectura, el clasificador recibe directamente estas etiquetas numéricas y aprende a separar las nueve regiones del espacio formado por las dos lecturas de entrada. En el modelo exportado, la capa final mantiene 9 neuronas, una por posición, y la clase estimada se obtiene tomando la salida de mayor valor. De este modo se conserva una interfaz sencilla para el firmware, que solo necesita comparar las activaciones de salida para determinar la posición reconocida.

\subsection{Entrenamiento y selección de la arquitectura}

El objetivo del proceso de entrenamiento es encontrar la red de menor tamaño posible que mantenga una precisión lo más cercana posible al 100\,\%, ya que una red más compacta ocupa menos memoria en el microcontrolador y reduce el tiempo de inferencia, aspecto crítico dado el ciclo de 10\,ms impuesto por la tasa de muestreo de la \gls{imu}.

La red se construirá sobre una arquitectura de cuatro capas: una capa de entrada de 2 neuronas, dos capas ocultas de tamaño variable y una capa de salida de 9 neuronas. Para seleccionar la configuración se sigue el siguiente procedimiento: se separa un 20\,\% del conjunto como test y, sobre el 80\,\% restante, se realiza una búsqueda con validación cruzada estratificada de 5 particiones. Las arquitecturas candidatas son (40,20), (64,32), (128,64) y (128,128), combinadas con distintos valores de regularización \textit{L2} y tasa de aprendizaje inicial. La métrica optimizada es el \textit{F1-score}, más adecuada que la precisión global cuando se quiere equilibrar el rendimiento entre clases.

\begin{figure}[htbp]
    \centering
    
    \caption[Selección de la arquitectura mediante validación cruzada]{Mejor \textit{F1} obtenido en validación cruzada para cada arquitectura candidata durante la búsqueda en rejilla.}
    \label{fig:precision_vs_neuronas}
\end{figure}

El mejor resultado de validación cruzada se obtiene con dos capas ocultas de 40 y 20 neuronas, regularización \textit{L2} de $10^{-5}$ y tasa de aprendizaje inicial de $3\cdot10^{-3}$. Con esta configuración se alcanza un \textit{F1} medio de 0.983 durante la validación cruzada. Al evaluar el modelo seleccionado sobre el conjunto de test reservado, la precisión obtenida es 0.935 y el \textit{F1} es de 0.934, valores suficientes para el uso previsto teniendo en cuenta que el firmware añade una confirmación temporal de la posición predicha.

\subsection{Compresión e integración con TensorFlow Lite}

Una vez seleccionada la arquitectura, el modelo se exporta al microcontrolador mediante TensorFlow Lite \cite{TFLite} y su adaptación para Arduino, la librería Eloquent \cite{Eloquent}. Para el proceso de compresión primero se congelan todos los pesos de la red convirtiéndolos de variables a constantes y se elimina la arquitectura de entrenamiento, conservando únicamente la parte de inferencia; en segundo lugar, los parámetros se cuantifican de punto flotante de 32 bits a punto fijo de 8 bits, reduciendo el tamaño del modelo en memoria.

El resultado de la compresión es un fichero \texttt{.h} que se incorpora directamente al programa del Arduino. La arquitectura seleccionada, de tamaño 2--40--20--9, combina un número reducido de parámetros con una separación suficiente entre clases próximas, por lo que mantiene bajo el coste de inferencia sin comprometer el ciclo temporal del sistema. La arquitectura final y sus caracteristicas se resume en la Tabla~\ref{tab:arquitectura_red}.

\begin{table}[htbp]
\centering
\caption[Arquitectura final de la red neuronal]{Resumen de la arquitectura
de la red neuronal seleccionada tras el proceso de entrenamiento.}
\label{tab:arquitectura_red}

\begin{tabular}{lcc}
\hline
\textbf{Capa} & \textbf{Tamaño de salida} & \textbf{N.º de parámetros} \\
\hline
Entrada & 2 & -- \\
Densa 1 (ReLU) & 40 & 120 \\
Densa 2 (ReLU) & 20 & 820 \\
Salida (Softmax) & 9 & 189 \\
\hline
\textbf{Total} & -- & \textbf{1129} \\
\hline
\end{tabular}
\end{table}

Complementando al clasificador, se implementa un mecanismo de confirmación de posición: el sistema solo registra un cambio de estado cuando la red predice la nueva posición de forma consistente durante un intervalo de tiempo mínimo. Dado que el ciclo de medida es de 10\,ms, significativamente inferior al tiempo de reacción motora del usuario, sin este mecanismo las transiciones entre posiciones o los errores puntuales de la red generarían detecciones espurias que degradarían la experiencia de control.

\section{Estudio de percepción de sensación táctil}

Con el hardware completamente ensamblado y el firmware de control operativo, el siguiente paso antes de integrar el sistema en la aplicación final es caracterizar y validar experimentalmente el módulo de estimulación electrotáctil. Este apartado recoge, en primer lugar, la caracterización del circuito para establecer la relación entre la configuración del potenciómetro digital y la corriente realmente inyectada en los electrodos. A partir de dicha caracterización se obtiene una curva de linealización que permite programar directamente valores de corriente desde el microcontrolador. En segundo lugar, se describe un estudio perceptivo realizado sobre el propio autor con el objetivo de evaluar la capacidad del sistema para generar sensaciones táctiles localizadas en los puntos de la mano definidos en la sección~2.

\subsection{Caracterización de la curva de corriente}

El potenciómetro digital MAX5413 admite valores de configuración $\mathrm{P}$ comprendidos entre 0 y 255 bits, que el microcontrolador transmite mediante el protocolo \gls{spi}. Internamente, este dispositivo actúa como una resistencia variable en la red de polarización del amplificador operacional LMV342, de modo que el valor de $\mathrm{P}$ determina la resistencia efectiva $R(P)$ del potenciómetro según la relación:

\begin{equation}
    R(\mathrm{P}) = R_{\max} \cdot \frac{\mathrm{P}}{255},
\end{equation}

donde $R_{\max}$ es la resistencia máxima del dispositivo, en este caso $10~\mathrm{k}\Omega$. Dado que el amplificador operacional junto con el transistor \gls{fet} configura una fuente de corriente controlada por voltaje, la corriente de salida queda determinada por la tensión en el nodo de control, que a su vez es inversamente proporcional a $R(\mathrm{P})$. La corriente resultante sigue por tanto la relación:

\begin{equation}
    I \propto \frac{1}{\mathrm{P}},
    \label{eq:curva_corriente}
\end{equation}

Esta dependencia hiperbólica implica que incrementos iguales de $\mathrm{P}$ no producen incrementos iguales de corriente, siendo la respuesta muy sensible a valores bajos de $\mathrm{P}$ y
progresivamente más plana a medida que $\mathrm{P}$ aumenta.

Para verificar experimentalmente esta relación y cuantificar el valor de $K$, se conectó una resistencia de carga conocida $R_L=1004 ~\Omega$ entre los terminales de salida del circuito en lugar de los electrodos. Midiendo la tensión $V_L$ en bornes de la
resistencia con un multímetro, la corriente se obtiene directamente como $I = V_L / R_L$. El procedimiento se repitió para varios valores de $\mathrm{P}$ entre 0 y 255, programando cada configuración desde el Arduino y registrando la medida correspondiente. Los resultados obtenidos se muestran en la
Figura~\ref{fig:curva_IP}.

\begin{figure}[htbp]
    \centering
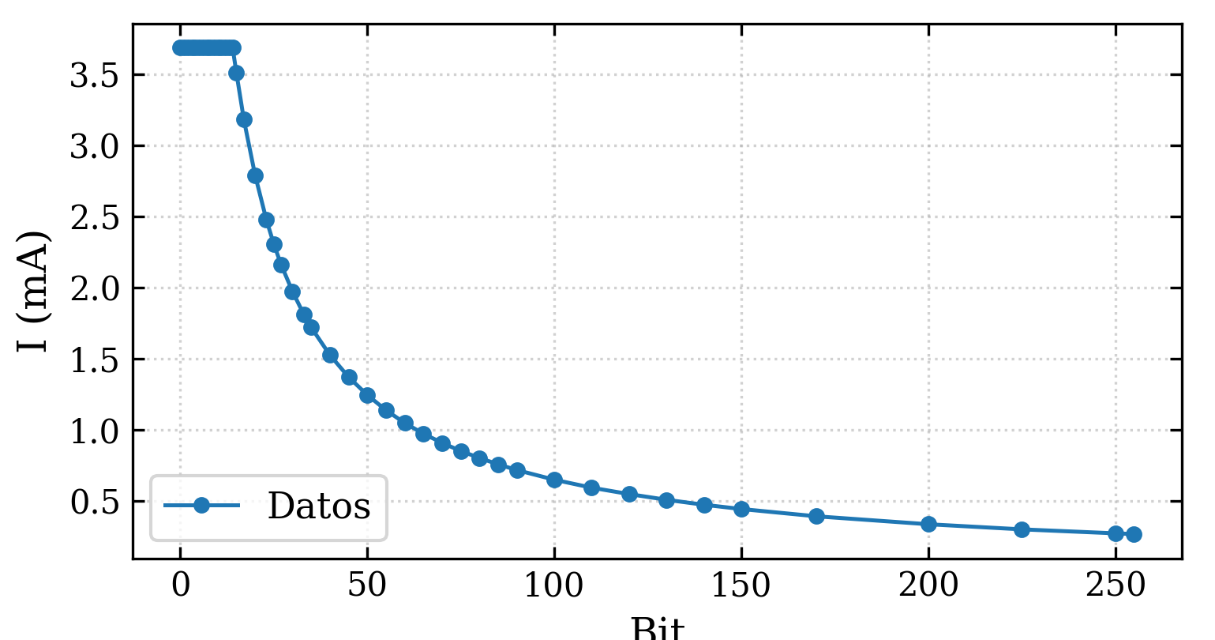
[picture p9: TFM_Guante_Haptico/Imagenes/curva_i_bit.png]
        
    \caption[Curva de corriente en función del valor del potenciómetro]{Corriente
    medida en la carga en función del valor de configuración $\mathrm{P}$ del potenciómetro
    digital. La curva presenta la forma hiperbólica $I \propto 1/P$ predicha, quitando la zona donde el diodo limitador de corriente empieza a tener efecto}
    \label{fig:curva_IP}
\end{figure}

\subsection{Linealización y regresión}

La relación hiperbólica de la ecuación~\eqref{eq:curva_corriente} resulta poco
conveniente para la caracterización del sistema, por lo que para obtener mediante una formula a que corriente corresponde cada valor de P, se procede a linealizar la curva mediante el cambio de variable $y = 1/I$, de modo que la relación entre corriente y variable transformada es lineal:

\begin{equation}
    y \propto  P
    \label{eq:linealizada}
\end{equation}

Sobre los datos experimentales transformados se realiza una regresión lineal por mínimos cuadrados, ajustando el modelo $y = a \cdot x + b$. Los parámetros del ajuste obtenidos son:

\begin{equation}
    \hat{a} = 0.01441 \, \qquad \hat{b} = 0.0824 \,
\end{equation}

con un coeficiente de determinación $R^2 = 0.9999$, lo que confirma la validez del modelo linealizado para describir el comportamiento del circuito en el rango de operación. Para el ajuste no se han tenido en cuenta los datos donde el diodo limitador de corriente tiene efecto. El ajuste se muestra superpuesto a los datos experimentales en la
Figura~\ref{fig:regresion}.

\begin{figure}[htbp]
    \centering
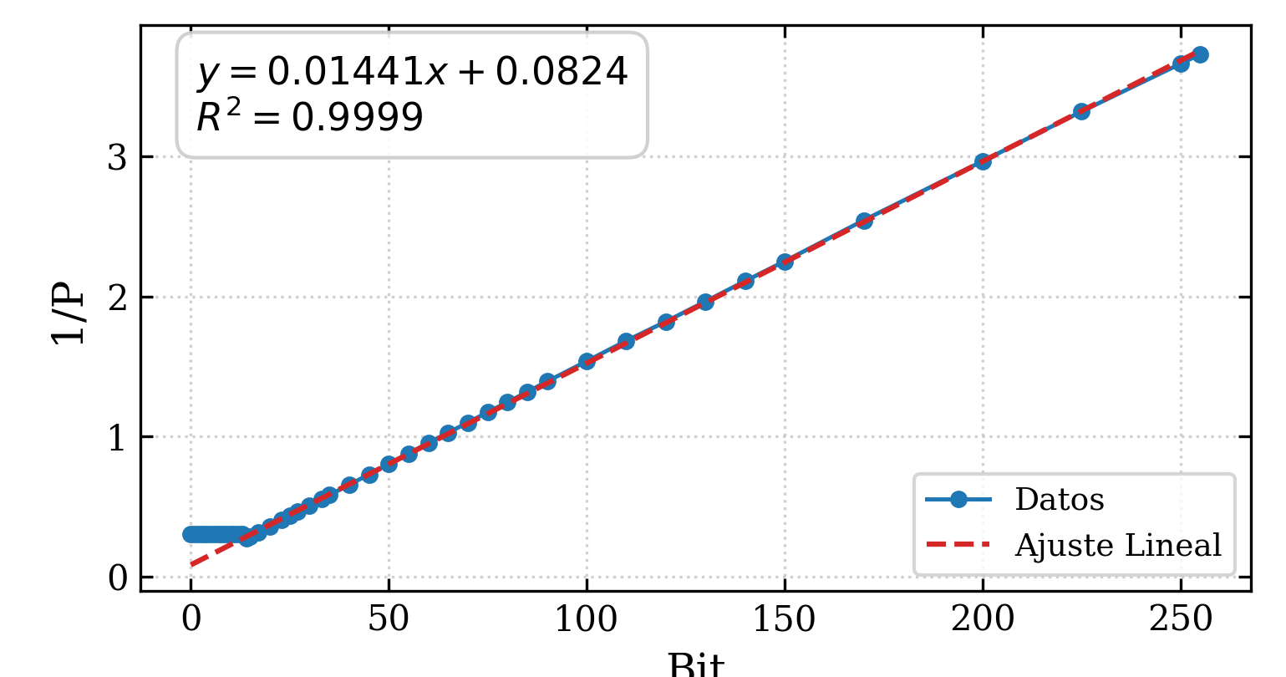
[picture p10: TFM_Guante_Haptico/Imagenes/curva_v_bit.png]
        
    \caption[Regresión lineal sobre la curva linealizada]{Corriente medida en función de $y$ junto con la recta de la regresión lineal. El elevado valor de $R^2$ confirma el comportamiento lineal tras el cambio de
    variable.}
    \label{fig:regresion}
\end{figure}

Por lo tanto, dado un valor de $\mathrm{P}$ el circuito dará una corriente de salida que seguirá la ecuación (\ref{eq:calibracion}):

\begin{equation}
    I(\mathrm{P})=\frac{1}{0,01441\cdot \mathrm{P}+0,0824}~mA
    \label{eq:calibracion}
\end{equation}

que se implementa en el firmware del Arduino para traducir cualquier valor de bit programado que se envía por \gls{spi} al MAX5413 con el valor de corriente correspondiente. De este modo, el resto del sistema opera en unidades de miliamperios, desacoplando la lógica de control de los detalles del circuito analógico.

Como se observa en las dos figuras, el diodo limitador E-452 integrado en serie garantiza que, ante cualquier combinación de parámetros, la corriente que entra en el multiplexador no supere los 4.5\,mA, por lo que la ecuación~\eqref{eq:calibracion} solo es válida en el rango $\mathrm{P} \in [15,\,255]$\,mA.
Los demás valores de $\mathrm{P}$ tendrán una corriente muy parecida a la que corresponde a $\mathrm{P}=15$.

\subsection{Estudio perceptivo}

Con el circuito caracterizado, se procede a validar el sistema
háptico mediante un estudio de percepción que se realizará sobre el propio autor. El objetivo será comprobar mediante un estudio rápido cuáles de los diez canales de estimulación, y con que polarización, son capaces de generar una sensación referida a la zona palmar esperada, descartando aquellos en los que la localización o la sensación no sea la correcta. Para ver los resultados conseguidos por un sistema similar pero con un número mayor de pacientes, se puede consultar la referencia \cite{Tanaka2023}.

\subsubsection{Protocolo experimental}

Para el estudio se emplea la señal \textit{Burst}, un pulso cuadrado de 50\,ms en estado activo, que produce una sensación puntual comparable a la de pulsar un botón. Para cada canal, se parte de un valor de $\mathrm{P}$ elevado, correspondiente a una corriente baja, y se va reduciendo progresivamente hasta que el autor detecta alguna sensación. En ese punto, se envian 5 pulsos consecutivos y se anota la zona de la mano en la que se ha percibido el estímulo. Si la zona indicada coincide con la zona palmar esperada para ese canal según el diseño de la sección~2, el canal se considera válido; en caso contrario, se descarta.

\subsubsection{Resultados}

La Tabla~\ref{tab:umbrales} recoge, para cada canal, la zona palmar objetivo, la polaridad de estimulación y el resultado del estudio. La Figura a la izquierda de la tabla muestra la correspondencia entre cada canal y su zona palmar asociada.
\newpage
\begin{table}[htbp]
    \centering
    \renewcommand{\arraystretch}{1.2}
    
    % --- COLUMNA IZQUIERDA: IMAGEN (a) ---
    \begin{minipage}[b]{0.42\textwidth}
        \centering
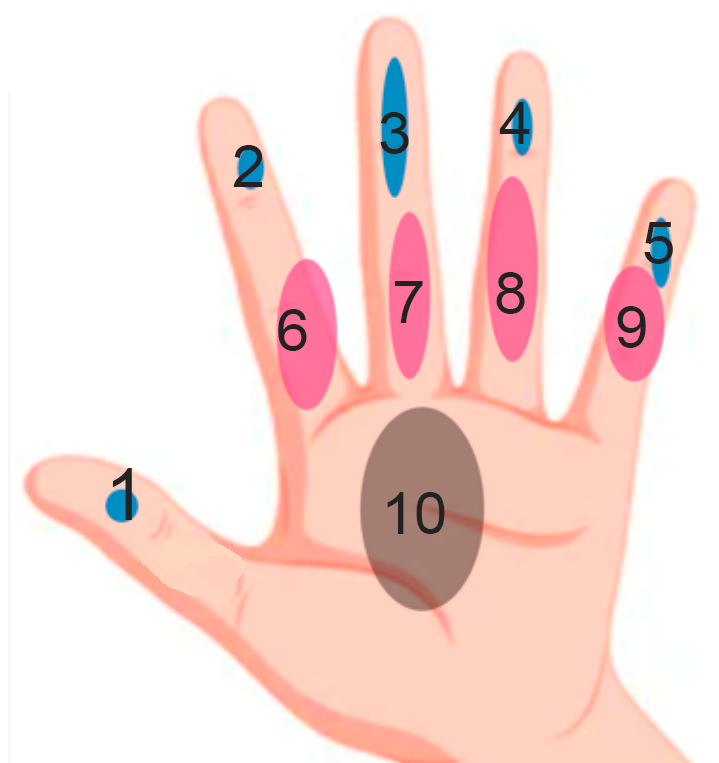
[picture p11: TFM_Guante_Haptico/Imagenes/canal_estimulacion.png]
        
        \small\textit{a) Zonas palmares objetivo por canal.}
    \end{minipage}
    \hfill % Espacio entre la imagen y la tabla
    % --- COLUMNA DERECHA: TABLA (b) ---
    \begin{subtable}[b]{0.54\textwidth}
        \centering
        \small % Reducimos un poco el texto de la tabla si es necesario para que quepa al lado
        \begin{tabular}{clcc}
            \hline
            \textbf{Canal} & \textbf{Zona objetivo} & \textbf{Polaridad} & \textbf{Válido} \\
            \hline
            \multirow{2}{*}{1}  & \multirow{2}{*}{Pulgar}           & Anódica  & Dorsal \\
                                  &                                   & Catódica & \checkmark \\
            \arrayrulecolor{gray!40}\hline\arrayrulecolor{black}
            \multirow{2}{*}{2}  & \multirow{2}{*}{Índice distal}    & Anódica  & \checkmark \\
                                  &                                   & Catódica & Dorsal\\
            \arrayrulecolor{gray!40}\hline\arrayrulecolor{black}
            \multirow{2}{*}{3}  & \multirow{2}{*}{Corazón distal}   & Anódica  & \checkmark \\
                                  &                                   & Catódica & Dorsal \\
            \arrayrulecolor{gray!40}\hline\arrayrulecolor{black}
            \multirow{2}{*}{4}  & \multirow{2}{*}{Anular distal}    & Anódica  & \checkmark \\
                                  &                                   & Catódica & \checkmark\\
            \arrayrulecolor{gray!40}\hline\arrayrulecolor{black}
            \multirow{2}{*}{5}  & \multirow{2}{*}{Meñique distal}   & Anódica  & \checkmark \\
                                  &                                   & Catódica & Dorsal\\
            \arrayrulecolor{gray!40}\hline\arrayrulecolor{black}
            \multirow{2}{*}{6}  & \multirow{2}{*}{Índice proximal}  & Anódica  & \checkmark\\
                                  &                                   & Catódica & Dorsal\\
            \arrayrulecolor{gray!40}\hline\arrayrulecolor{black}
            \multirow{2}{*}{7}  & \multirow{2}{*}{Corazón proximal} & Anódica  & \checkmark \\
                                  &                                   & Catódica & 50/50 \\
            \arrayrulecolor{gray!40}\hline\arrayrulecolor{black}
            \multirow{2}{*}{8}  & \multirow{2}{*}{Anular proximal}  & Anódica  & \checkmark \\
                                  &                                   & Catódica & 50/50\\
            \arrayrulecolor{gray!40}\hline\arrayrulecolor{black}
            \multirow{2}{*}{9}  & \multirow{2}{*}{Meñique proximal} & Anódica  & \checkmark \\
                                  &                                   & Catódica & 50/50 \\
            \arrayrulecolor{gray!40}\hline\arrayrulecolor{black}
            \multirow{2}{*}{10} & \multirow{2}{*}{Palma}            & Anódica  & $\times$ \\
                                  &                                   & Catódica & \checkmark \\
            \hline
        \end{tabular}
        \caption{Validación perceptiva.}
        \label{tab:umbrales_datos}
    \end{subtable}

    \vspace{10pt} % Espacio entre los elementos y el caption principal
    % --- CAPTION PRINCIPAL DETALLADO ---
    \caption[Estudio de localización y validación por canal]{Estudio de localización del estímulo: 
    \textbf{a)} Zonas palmares correspondientes a cada canal de estimulación. 
    \textbf{b)} Resultado del estudio de localización para cada canal y polaridad de estimulación. La columna \textit{Válido} indica si la sensación referida coincidió con la zona esperada (\checkmark), si se percibió en la zona Dorsal, si se percibió en ambas partes (50/50), o si no se percibió ninguna sensación ($\times$).}
    \label{tab:umbrales}
\end{table}

Los resultados obtenidos muestran un comportamiento divergente respecto a la hipótesis inicial planteada en el Desafío~4 sobre el efecto de la polaridad. Contrariamente a lo esperado, la estimulación catódica no logró evocar la sensación referida en la mayoría de las falanges distales; para los canales 2, 3 y 5 (índice, corazón y meñique distales), esta configuración desvió la percepción hacia la zona dorsal, invalidando su uso. Por el contrario, la estimulación anódica demostró ser la más efectiva para la gran mayoría de los canales digitales (del 2 al 9), logrando activar con éxito las zonas palmares tanto proximales como distales. 

No obstante, la estimulación catódica resultó indispensable para el éxito del canal 1 (pulgar) y el canal 10 (palma), puntos en los cuales la configuración anódica falló al desviar la sensación al dorso o no generar estímulo perceptible ($\times$). El canal 4 (anular distal) fue el único que exhibió una respuesta válida bajo ambas polaridades. 

Por otra parte, se registró que la corriente promedio en la que se comenzó a percibir la sensación táctil en los canales válidos fue de $3.38~mA$. Este umbral resulta notablemente elevado, puesto que se aproxima al límite de $4.5~mA$ impuesto por el diodo limitador de seguridad, lo que restringe el rango dinámico útil para modular la intensidad de la sensación. 

A pesar de la desviación teórica en el comportamiento de la polaridad catódica, la validación perceptiva confirma la viabilidad del diseño: mediante una selección indexada de la polaridad según el canal activo (configuración catódica para los canales 1 y 10, y anódica para el resto), el sistema es capaz de proyectar de forma selectiva y diferenciada el estímulo en las 10 zonas palmares objetivo. Este resultado determina el subconjunto de canales que se podrán emplear en la aplicación de control de la sección~\ref{sec:dron}.

% ==============================================================
% SECCIÓN: Control de dron como aplicación del sistema háptico
% ==============================================================

\section{Aplicación del sistema: control de un dron con feedback háptico}
\label{sec:dron}

Como aplicación del sistema desarrollado, para poner a prueba todo el trabajo en su conjunto, se decidió implementarlo como método de control de vuelo de un dron comercial de bajo coste, concretamente el modelo Karuisrc K417, empleando el guante como dispositivo de mando. La elección de esta plataforma responde a que el vuelo de un dron requiere gestionar de forma simultánea cuatro grados de libertad: aceleración (\textit{throttle}), guiñada (\textit{yaw}), cabeceo (\textit{pitch}), alabeo (\textit{roll}). Esto es útil para obligar a activar en paralelo todos los subsistemas del guante: la estimación de orientación mediante el filtro de Mahony, la lectura de los sensores de flexión, el reconocimiento gestual mediante la red neuronal embebida y la retroalimentación háptica electrotáctil. El resultado es un bucle de control en el que el piloto actúa sobre el dron inclinando y girando la mano, mientras usa la posición de los dedos como canal adicional de control, a la vez que el sistema le devuelve información táctil localizada sobre la maniobra que está ejecutando, sin recurrir a ningún tipo de retroalimentación visual del estado del vuelo.

% ------------------------------------------------------------------
\subsection{Protocolo WiFi de control del dron}
\label{sec:dron_protocolo}
% ------------------------------------------------------------------

Para poder mandar ordenes al dron, se usa su punto de acceso Wi-Fi propio, pero el problema es que no dispone de documentación pública sobre su protocolo de comunicación. Para poder controlarlo desde el microcontrolador fue necesario caracterizar dicho protocolo mediante la captura de tráfico en red local. El procedimiento consistió en conectar un ordenador a la misma red inalámbrica que la aplicación para Android del dron y, mediante scripts desarrollados en Node.js y Python (disponibles en el Anexo \ref{Anexo:A}), interceptar y registrar todos los datagramas \gls{udp} que la app enviaba hacia la dirección IP del dron 192.168.169.1 a través del puerto 8800. Actuando sobre los controles de la aplicación de forma sistemática y observando simultáneamente cómo cambiaba el contenido de los paquetes capturados, fue posible asociar cada campo de la cadena binaria a la función de vuelo correspondiente.

El análisis reveló que cada mensaje de control tiene una longitud fija de 124 bytes y está estructurado en cuatro bloques lógicos separados por campos de verificación y contadores de secuencia. La Tabla~\ref{tab:pkt_estructura} resume la organización del datagrama identificada en este proceso.

\begin{table}[htbp]
\centering
\caption{Estructura del datagrama \gls{udp} de 124\,bytes del protocolo K417.}
\label{tab:pkt_estructura}
\setlength{\tabcolsep}{8pt}
\renewcommand{\arraystretch}{1.25}
\begin{tabular}{@{}llccp{5.2cm}@{}}
\toprule
\textbf{Bloque} & \textbf{Campo} & \textbf{Bytes} & \textbf{Naturaleza} & \textbf{Descripción} \\
\midrule
Cabecera
  & Sincronización     & 12 & Fijo     & Constante \texttt{0xEF\,0x02\,\ldots} \\
\midrule
\rowcolor{rowgray}
\multirow{4}{*}{C1}
  & Ejes de vuelo      &  4 & Variable & Roll, pitch, yaw, throttle como \texttt{uint8} en $[40,220]$; neutro = 128 \\
  & Comando especial   &  1 & Variable & Despegue, aterrizaje, parada, calibración (ver Tabla~\ref{tab:pkt_comandos}) \\
\rowcolor{rowgray}
  & Modo \textit{headless} / acrobacia & 1 & Variable & \texttt{0x02} off, \texttt{0x03} on; OR \texttt{0x08} activa acrobacia \\
  & Relleno + CRC      & 17 & Fijo/Var.& 10\,B de ceros + XOR de los 6\,bytes de control + sufijo fijo \\
\midrule
Checksum
  & Contadores de sec. & 14 & Variable & Prefijo fijo + tres contadores de 16\,bits (\texttt{ctr1}, \texttt{ctr2}, \texttt{ctr3}) \\
\midrule
C2
  & \texttt{ctr2} + sufijo & 32 & Variable & Primeros 2\,bytes: contador de secuencia; resto sufijo \\
C3
  & \texttt{ctr3} + sufijo & 34 & Variable & Primeros 2\,bytes: contador de secuencia; resto sufijo \\
\midrule
\textbf{Total} & & \textbf{124} & & \\
\bottomrule
\end{tabular}
\end{table}

Dentro del bloque C1 se sitúan los cuatro bytes de ejes de vuelo, cada uno codificado como un entero sin signo en el rango $[40,\,220]$, donde el valor 128 representa el punto neutro. El mismo bloque alberga un byte de comando especial, que puede tomar valores predefinidos para ordenar el despegue automático, el aterrizaje, la calibración de la \gls{imu} interna del dron, el movimiento de la cámara o el inicio de una acrobacia, y un byte de modo sin cabeza (\textit{headless}), que controla si el dron interpreta los ejes de traslación respecto a su propia orientación instantánea o respecto a la que tenía en el momento del despegue. Los bloques C2 y C3 repiten parte de la información de vuelo con campos de estado adicionales y cierran el datagrama con un sufijo de bytes de valor fijo que actúa como delimitador. La Tabla~\ref{tab:pkt_comandos} recoge los valores del byte de comando especial identificados durante la captura y su significado.

\begin{table}[htbp]
\centering
\caption{Valores del byte de comando especial en el bloque C1 del protocolo K417.}
\label{tab:pkt_comandos}
\begin{tabular}{cll}
\hline
\textbf{Valor (hex)} & \textbf{Constante en firmware} & \textbf{Acción} \\
\hline
\texttt{0x00} & \texttt{CMD\_NONE}        & Ninguna (control normal)    \\
\texttt{0x01} & \texttt{CMD\_TAKEOFF}     & Despegue automático         \\
\texttt{0x02} & \texttt{CMD\_STOP}        & Parar motores   \\
\texttt{0x04} & \texttt{CMD\_CALIBRATE}   & Calibración de la IMU del dron \\
\texttt{0x05} & \texttt{CMD\_LAND}     & Aterrizaje suave              \\
\texttt{0x08} & \texttt{SOMERSAULT\_FLAG} & Activar modo acrobacia \\
\hline
\end{tabular}
\end{table}

Para realizar la maniobra de acrobacia, a parte de mandar el valor \texttt{0x08} en el byte de comando, hay que lleva a cabo un proceso extra para que el dron de piruetas mediante un sistema de dos fases. Durante la primera fase de impulso, se envían 20 paquetes consecutivos con el indicador de acrobacia activado en el byte de comando y el acelerador forzado a 212 sobre el máximo de 220, con el fin de dotar al dron del empuje necesario para completar el giro. Superado ese bloque de paquetes, se entra en la fase de recuperación, en la que se envían 10 paquetes adicionales con el acelerador reducido a 204 para estabilizar el vuelo antes de devolver el control al lazo normal. Durante las dos fases, los ejes de traslación permanecen congelados en los valores previos para impedir que movimientos involuntarios de la mano generen comandos espurios durante la maniobra.
% ------------------------------------------------------------------
\subsection{Bucle de control}
\label{sec:dron_bucle}
% ------------------------------------------------------------------

La totalidad del procesamiento y comunicación con el dron se ejecuta en el microcontrolador Arduino Nano RP2040 Connect sin intervención de ningún sistema externo. El bucle principal envía los paquetes de control al dron a 40\,Hz, y la red neuronal realiza una predicción cada 80\,ms, mientras el resto del procesamiento se mantiene a 100\,Hz. En esta sección se describen las etapas que se ejecutan en cada iteración del bucle, desde la lectura de sensores hasta el envío de comandos al dron y la actualización de la retroalimentación háptica.

\subsubsection{Estimación de orientación.} Al inicio de cada iteración se leen las medidas de acelerómetro y giroscopio del sensor LSM6DSOX y se integran en el filtro de Mahony para actualizar el cuaternión de orientación. Durante la fase de calibración inicial, que comprende 200 muestras tomadas con el guante en reposo, se estiman y corrigen los sesgos de \textit{offset} del giroscopio. El filtro opera con ganancia proporcional $K_p = 3{.}5$ y ganancia integral $K_i = 0{.}03$, valores que experimentalmente se ha comprobado que proporcionan una convergencia rápida de la estimación frente a las perturbaciones de aceleración que se producen durante el movimiento de la mano.

\subsubsection{Mapeo de orientación a ejes de vuelo.}
A partir del cuaternión se extraen los ángulos de Euler de \textit{yaw}, \textit{pitch} y \textit{roll}. Antes de convertirlos en los bytes del joystick virtual se aplica sobre cada eje un procesamiento extra que se ha calibrado para optimizar el control del vuelo: una zona muerta de $10^\circ$ que cancela las desviaciones de orientación menores para suprimir temblores de la mano; una función de exposición no lineal que suaviza la respuesta en torno al punto neutro y la amplifica en los extremos del recorrido; y un escalado lineal que convierte el ángulo resultante, acotado a un máximo de $45^\circ$, al rango entero $[40,\,220]$ con 128 como valor neutro.

\subsubsection{Control del acelerador mediante sensores de flexión.}
Los dos piezoresistivos que no han sido usados en el clasificador de gestos se usan finalmente para controlar el \textit{throttle} (acelerador). Así, las entradas analógicas A2 (flexión del dedo índice) y A3 (flexión del dedo corazón) controlan el nivel de aceleración vertical del dron. La diferencia entre sus lecturas normalizadas, calculada respecto a la media y desviación típica registradas durante la calibración, se filtra mediante un promedio exponencial de primer orden con coeficiente $\alpha = 0{.}12$ para eliminar transitorios bruscos y se mapea al mismo rango $[40,\,220]$.

\subsubsection{Reconocimiento gestual y comandos discretos.}
La red neuronal \textit{fully-connected} embebida procesa a aproximadamente 12.5~Hz (cada 80.0~ms) las lecturas normalizadas de los cuatro sensores de flexión y produce una estimación del gesto activo entre nueve posibles. Para reducir la tasa de falsos positivos, el firmware exige que la clase predicha se mantenga estable durante al menos 350~ms y que el margen de confianza supere un umbral mínimo antes de activar el comando de vuelo asociado. Una vez ejecutado un comando, se impone un período de bloqueo de 900~ms durante el cual no puede activarse ninguna acción nueva. La Tabla~\ref{tab:nn_gestos} relaciona las clases gestuales con los comandos de vuelo.

\begin{table}[htbp]
\centering
\caption[Correspondencia entre clase gestual, comando de vuelo y retroalimentación háptica de confirmación]{Correspondencia entre clase gestual, comando de vuelo y retroalimentación háptica de confirmación. Para ver qué posición corresponde a cada clase, ver Figura~\ref{fig:posiciones_dataset}.}
\label{tab:nn_gestos}
\begin{tabular}{cl}
\hline
\textbf{Posición} & \textbf{Comando de vuelo} \\
\hline
0 & Sin acción \texttt{0x00}\\
1 & Parar motor \texttt{0x02}\\
2 & Aterrizaje \texttt{0x05}\\
3 & Despegue \texttt{0x01}\\
4 & Reset \gls{imu} Arduino\\
5 & Modo \textit{headless} ON/OFF\\
6 & Calibrar \gls{imu} dron \texttt{0x04} \\
7 & Modo acrobacia ON \texttt{0x08}\\
8 & --- \\
\hline
\end{tabular}
\end{table}

\subsubsection{Actualización de la retroalimentación háptica.}
Una vez calculados los valores de los cuatro ejes de vuelo y resueltas las acciones del clasificador, el firmware procesa el estado de la estimulación táctil. En este punto del ciclo se determina si corresponde activar una ráfaga corta de confirmación o si se debe modular el tren de pulsos continuo según la desviación de los ejes virtuales. Dado que este bloque gestiona directamente la interfaz física con el usuario, la lógica interna de multiplexado, el mapa de zonas anatómicas y los parámetros eléctricos de los estímulos se delegan y detallan en profundidad en la Sección~\ref{sec:haptic_drone}.

Finalmente, la Tabla~\ref{tab:tiempos_bucle_horizontal} recoge el tiempo de ejecución medido para cada etapa del ciclo. El tiempo total es de aproximadamente 6{.}88\,ms, lo que garantiza que el bucle puede ejecutarse a 40\,Hz sin riesgo de retrasos. La condición de 100\,Hz impuesta por la librería de la \gls{imu} también se cumple, por lo que el sistema es capaz de procesar toda la información sensorial, ejecutar la red neuronal y generar la retroalimentación háptica a una cadencia suficiente para el control de vuelo en tiempo real. Cabe destacar que la tabla indica el ciclo más lento posible, ya que el envio WiFi se da solo en cuatro de cada diez ciclos debido a que opera a 40\,Hz, y el de la red neuronal se da en uno de cada ocho puesto que funciona a 12{.}5\,Hz, mientras que el resto de etapas se ejecutan en cada iteración a 100\,Hz. Por lo tanto, en todos los ciclos donde no haya envio WiFi ni clasificación de la red neuronal, el ciclo cumple la condición de 10\,ms con aun mayor holgura.

\begin{table}[htbp]
\centering
\caption{Desglose de tiempos de ejecución de un ciclo completo de programa.}
\label{tab:tiempos_bucle_horizontal}
\resizebox{\textwidth}{!}{% 
\begin{tabular}{|l|c|c|c|c|c|c|c|c|}
\hline
\rowcolor{light-gray} & \textbf{IMU (Lectura y Filtro)} & \textbf{ADC} & \textbf{Red Neuronal} & \textbf{Lógica CPU} & \textbf{Envío WiFi} & \textbf{Hápticos} & \textbf{Otros} & \textbf{TOTAL} \\ \hline
\textbf{Tiempo (ms)} & 3.494 & 0.083 & 1.415 & 0.212 & 2.115 & 0.403 & 0.039 & \textbf{6.880} \\ \hline
\end{tabular}
}
\end{table}

% ------------------------------------------------------------------
\subsection{Retroalimentación háptica durante el vuelo}
\label{sec:haptic_drone}
% ------------------------------------------------------------------

Partiendo de la información generada en el bucle de control, la retroalimentación háptica informa al piloto del estado de los ejes continuos y confirma los comandos de vuelo discretos reconocidos por el clasificador gestual, todo ello mediante estimulación electrotáctil sobre el dorso de la mano. Cada eje de control y cada acción gestual tienen asignada una zona anatómica distinta, de modo que el piloto puede interpretar táctilmente el comportamiento del sistema sin apartar la vista del dron. La Tabla~\ref{tab:haptic_mapeo} recoge el esquema completo, con las posiciones de la matriz de conmutación HV2701 y los parámetros de estímulo correspondientes, entre ellos el valor $\mathrm{P}$ del potenciómetro que el autor calibró según las preferencias individuales.

\begin{table}[htbp]
\centering
\caption{Esquema de retroalimentación háptica: ejes de control continuo y comandos discretos del clasificador gestual.}
\label{tab:haptic_mapeo}
\resizebox{\textwidth}{!}{%
\begin{tabular}{lllc}
\toprule
\textbf{Eje / Clase gestual} & \textbf{Zona anatómica} & \textbf{Posición HV2701} & \textbf{Estímulo} \\
\midrule
\multicolumn{4}{l}{\textbf{Canales continuos (tren de pulsos a 100\,Hz, 400\,\textmu{}s)}} \\
\textit{Yaw} (Rotación horizontal)       & Pulgar       & M4  & Tren ($\mathrm{P} \in [16-25]$) \\
\textit{Pitch} (Avance / retroceso)      & Índice       & M8  & Tren ($\mathrm{P} \in [23-28]$) \\
\textit{Roll} (Desplazamiento lateral)   & Medio-anular & M12 & Tren ($\mathrm{P} \in [28-35]$) \\
\textit{Throttle} (Aceleración vertical) & Palma        & M20 & Tren ($\mathrm{P} \in [14-20]$) \\
\midrule
\multicolumn{4}{l}{\textbf{Comandos discretos (ráfagas de pulsos, 50\,ms ON)}} \\
Clase 0: Neutro                               & —            & —   & Sin estímulo \\
Clase 1: Parar motor & Palma        & M20 & Ráfaga (1 pulso,  $\mathrm{P} = 18$) \\
Clase 2: Aterrizaje       & Índice       & M8  & Ráfaga (1 pulso,  $\mathrm{P} =25$) \\
Clase 3: Despegue            & Pulgar       & M4  & Ráfaga (1 pulso,  $\mathrm{P} =20$) \\
Clase 4: Reset \gls{imu} Arduino             & Medio-anular & M12 & Ráfaga (1 pulso,  $\mathrm{P} =30$) \\
Clase 5: Modo \textit{headless} ON/OFF & Índice       & M8  & Ráfaga (3 pulsos,  $\mathrm{P} =25$) \\
Clase 6: Calibrar IMU dron                 &  Medio-anular & M12 & Ráfaga (3 pulsos, $\mathrm{P} =30$) \\
Clase 7: Modo acrobacia ON                & Palma        & M20 & Ráfaga (3 pulsos, $\mathrm{P} =18$) \\
Clase 8: Sin acción asignada                  & —            & —   & Sin estímulo \\
\bottomrule
\end{tabular}
}
\end{table}

La retroalimentación continua opera a una cadencia de 10\,ms. En cada ciclo se calcula la desviación de cada eje respecto al neutro y se normaliza al rango $[0,\,1]$. Este valor se mapea de forma inversa sobre el rango de potenciómetro asignado a la zona correspondiente: a mayor desviación, menor resistencia y, por tanto, mayor intensidad de estímulo. Cuando varios ejes están activos simultáneamente, la simultaneidad no se implementa manteniendo un tren continuo común mientras se conmuta el HV2701, sino serializando la estimulación en pulsos individuales. En cada pulso, el firmware fuerza primero el cierre de la matriz, ajusta el potenciómetro MAX5413 al valor del eje seleccionado, habilita únicamente la ruta correspondiente durante el ancho de pulso y vuelve a abrir la matriz antes de pasar al siguiente eje activo. La selección de ejes sigue un recorrido circular entre los canales activos, de modo que todos reciben pulsos periódicos sin solapamiento eléctrico directo. Cuando todos los ejes vuelven al neutro, la secuencia se detiene de forma inmediata.

Cuando el clasificador reconoce un comando discreto, se interrumpe la señal de tren y se emite una ráfaga de pulsos de 50\,ms en la zona anatómica asociada a dicha acción. Un temporizador de bloqueo calculado a partir de la duración total de la ráfaga impide cualquier solapamiento con la estimulación continua hasta que esta concluye. El número de pulsos de la ráfaga diferencia unos eventos de otros: un pulso confirma acciones operativas estándar como el despegue, el aterrizaje o el reset de la orientación, mientras que tres pulsos se reservan para eventos como la activación del modo acrobacia o la conmutación del modo \textit{headless}. Durante la ejecución física de una maniobra de acrobacia, toda la retroalimentación háptica se suspende, ya que los ejes de control están congelados por el secuenciador de recuperación y el estímulo no aportaría información útil al piloto.

\section{Conclusiones y trabajo futuro}
\label{sec:conclusiones}

En lineas generales, este trabajo ha servido como plataforma para poner a prueba un sistema donde se integran la parte de sensado y actuación electrónica en un dispositivo portátil, la parte de procesamiento de señal y aprendizaje automático en un microcontrolador embebido, y la parte de ingeniería inversa de protocolos de comunicación Wi-Fi para controlar un dron comercial. El resultado es un sistema funcional que permite controlar el vuelo de un dron mediante gestos de la mano con retroalimentación háptica localizada, lo que demuestra la viabilidad de esta tecnología para aplicaciones de control remoto.

Respecto al trabajo previo, se ha mejorado la parte de proceesado de datos de la \gls{imu}, consiguiendo un resultado muy robusto frente a problemas típicos de este tipo de sensores, usando además funciones computacionalmente eficientes que permiten su ejecución en tiempo real en el microcontrolador. En cuanto a la parte de aprendizaje automático, se ha conseguido implementar un clasificador de gestos igual de funcional a pesar de reducir la dimensión de los datos de entrada a la mitad, cosa que ha permitido usar esos ejes en otras tareas de control.

Para poner a prueba el sistema en su conjunto, la aplicación de control de un dron comercial ha servido para validar la integración de todos los bloques funcionales y demostrar su utilidad en una tarea compleja que requiere gestionar múltiples grados de libertad en tiempo real y con una gran sensibilidad al tratarse de un dispositivo volador. El proceso de ingeniería inversa del protocolo Wi-Fi del dron ha sido un desafío técnico importante, pero ha permitido obtener un control total sobre la plataforma sin necesidad de hardware adicional.

Como linea futura, en este trabajo se ha dejado inexplorada la experimentación de distintos tipos de señales electricas para la estimulación electrotáctil, por lo que un estudio sistemático de parámetros como la frecuencia, la duración de los pulsos, la forma de onda o el número de pulsos en cada ráfaga podría optimizar la percepción táctil y ampliar el tipo de sensaciones que se pueden generar. Además, que los electrodos tuvieran que entrar en el guante ha supuesto que el sistema pueda resultar algo aparatoso, pero esto en dificil de evitar ya que requeriria del uso de un sistema de detección de flexión de los dedos completamente nuevo que prescindiera de dicha prenda.

Como mejora de hardware, se podria cambiar el potenciometro usado por uno de menor resistencia nominal, ya que los valores de $\mathrm{P}$ usados se encuentran en la parte donde la curva es más pronunciada, haciendo que los saltos de corriente entre bits sean muy grandes. Además, para poder experimentar con señales electricas de estimulación, habría que cambiar el microcontrolador usado por otro que disponga de un \gls{dac} integrado, o añadir circuiteria externa que fuera capaz de generar señales.

En definitiva, este trabajo ha servido para demostrar la viabilidad de un sistema de control remoto con retroalimentación háptica basado en un guante sensorizado y un microcontrolador embebido, y ha abierto la puerta a futuras mejoras tanto en la parte de estimulación táctil como en la parte de hardware para optimizar su rendimiento y comodidad de uso.

%------------------ BIBLIOGRAFÍA ------------------
\newpage
\bibliographystyle{unsrt}
\bibliography{Bibliografia_TFM}

%------------------ ANEXOS ------------------
\newpage
\pagenumbering{roman}
\section*{Anexos}

\begin{appendices}

\section{Repositorio de GitHub}
\label{Anexo:A}

Todo el código desarrollado y utilizado durante este Trabajo Fin de Máster se encuentra disponible en el repositorio público:

\begin{center}
\url{https://github.com/unax4/Haptic-stimulation-and-drone-control}
\end{center}

El repositorio actúa como material complementario de la memoria y está organizado para que la versión pública resulte legible y reproducible. Por ello, la estructura principal se centra en las versiones activas del firmware, la documentación técnica asociada y las herramientas necesarias para entender el flujo completo del sistema, desde la adquisición del movimiento hasta la generación de estimulación electrotáctil y el control del dron.

La plataforma final del trabajo se encuentra en la carpeta \texttt{drone\_k417/}, ya que el dron Karuisrc K417 es el modelo utilizado en la demostración completa descrita en la Sección~\ref{sec:dron}. En esta carpeta se incluye el firmware embebido modular final, cuyo archivo principal es \texttt{drone\_k417.ino}. A su alrededor se organizan varios ficheros de cabecera que separan la lógica de estimación de orientación mediante \gls{imu}, el control háptico, la comunicación serie, el protocolo de red, el estado del sistema y la inferencia de la red neuronal. De este modo, el repositorio público conserva la modularidad final del sistema sin mantener duplicadas las versiones monolíticas previas en la ruta principal.

La carpeta \texttt{drone\_e58/} recoge la plataforma prototipo utilizada para derivar y validar la lógica de control de vuelo antes de trasladarla al K417. En ella se conserva el firmware modular equivalente para el E58, junto con los scripts de control desde ordenador y la documentación de su protocolo Wi-Fi. Esta parte del repositorio permite seguir la evolución del trabajo: primero se desarrolló y verificó el control sobre una plataforma E58, y posteriormente dicha lógica se adaptó e integró en la versión final con realimentación háptica implementada sobre el K417.

Para la validación aislada de la electrónica de estimulación se incluye la carpeta \texttt{control\_pcb/}. Esta contiene un programa independiente del dron, utilizado para probar la \gls{pcb} del sistema electrotáctil, comprobar el funcionamiento del potenciómetro digital, la matriz de conmutación de alto voltaje y el encaminamiento de los electrodos. Su función es permitir ensayos eléctricos y de sensaciones sin depender del resto de la aplicación de vuelo.

Una parte importante del repositorio corresponde a la documentación del protocolo de comunicación y del sistema háptico. Archivos como \texttt{drone\_k417/K417\_PROTOCOL.md}, \texttt{drone\_e58/E58\_WIFI\_CAM\_PROTOCOL.md} y \texttt{HAPTIC\_FEEDBACK\_SYSTEM\_DOCUMENTATION.md} describen la estructura de los paquetes, los puertos utilizados, los comandos especiales y la organización del subsistema de estimulación. Esta documentación complementa lo expuesto en la memoria y facilita reproducir el proceso de ingeniería inversa seguido para controlar un dron comercial sin disponer de especificaciones públicas del fabricante.

Las carpetas \texttt{neural/}, presentes dentro de los proyectos de dron, contienen los \textit{datasets}, scripts de entrenamiento, modelos exportados y cabeceras generadas para la inferencia embebida. Estos recursos corresponden al clasificador gestual descrito en esta memoria y permiten reconstruir la cadena completa: adquisición de datos con sensores piezorresistivos, entrenamiento del modelo y despliegue final en el Arduino Nano RP2040 Connect. Finalmente, la carpeta \texttt{TFM\_Guante\_Haptico/} contiene el código fuente de la propia memoria, de modo que el repositorio no solo recoge el prototipo final, sino también la documentación técnica completa del trabajo.
\end{appendices}

\end{document}
