unax4/Haptic-stimulation-and-drone-control/TFM_Guante_Haptico/main.pdf

# Trabajo Fin de Máster

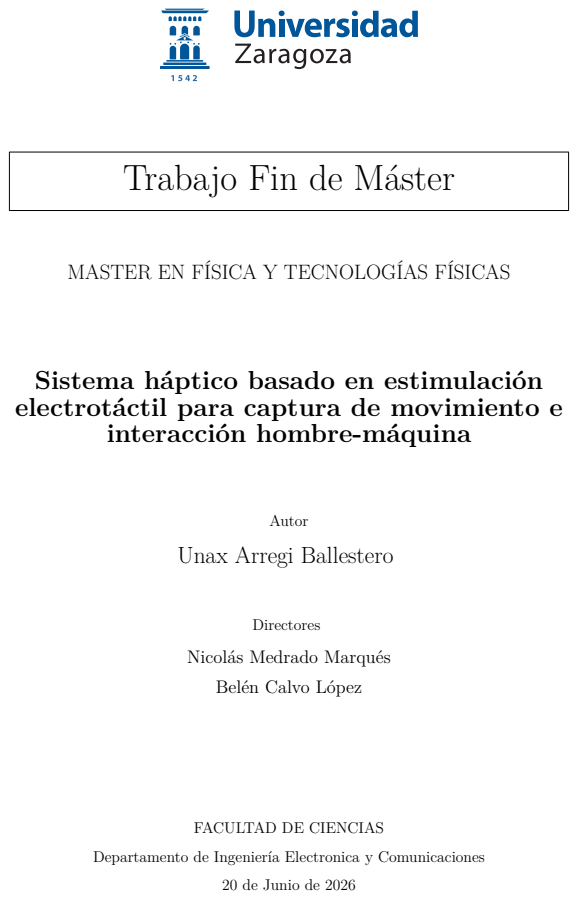
[picture p12: page 1]

MASTER EN FÍSICA Y TECNOLOGÍAS FÍSICAS

Sistema háptico basado en estimulación
electrotáctil para captura de movimiento e
interacción hombre-máquina

Autor
Unax Arregi Ballestero

Directores
Nicolás Medrado Marqués
Belén Calvo López

FACULTAD DE CIENCIAS

Departamento de Ingeniería Electronica y Comunicaciones

20 de Junio de 2026

## Agradecimientos

Especial gracias a MI por creer en MI y constantemente apoyar a MI. Sin MI jamas podria haber hecho todo esto.

i

## Lista de Figuras

2.1. Diferencia de agrupación nerviosa | 2
2.2. Asimetría de umbrales en la mano | 3
2.3. Configuración final del sistema háptico | 4
3.1. Montaje final del sistema háptico | 5
3.2. Esquema del circuito de estimulación electrotáctil diseñado para el guante. 7
3.3. Diseño final de la PCB del circuito de estimulación electrotáctil desarrollado en KiCad y resultado final una vez se recibió de la fábrica. Agradecimientos a Diego Antolín por su ayuda con el diseño y a Óscar
Lasarte por montar la placa | 9
5.1. Arquitectura de red neuronal fully connected | 13
5.2. Posiciones definidas para el dataset | 14
5.3. Distribución del dataset por posición | 14
5.4. Distribución de valores ADC por posición | 14
5.5. Funciones de activación | 15
5.6. Evolución de la precisión con el tamaño de la primera capa oculta | 15
5.7. Arquitectura final de la red neuronal | 16
6.1. Curva de corriente en función del valor del potenciómetro | 18
6.2. Regresión lineal sobre la curva linealizada | 18
7.1. Diagrama de flujo del bucle de control embebido ejecutado a 40 Hz | 23
7.2. Distribución de las cuatro zonas de retroalimentación háptica sobre el dorso
de la mano para el control del dron | 26

ii

## Lista de Tablas

6.1. Estudio de localización y validación por canal | 20
7.1. Estructura del datagrama UDP de 124 bytes del protocolo K417 | 21
7.2. Estructura del datagrama UDP de 124 bytes del protocolo K417 | 22
7.3. Valores del byte de comando especial en el bloque C1 del protocolo K417. . 22
7.4. Correspondencia entre clase gestual, comando de vuelo y retroalimentación
háptica de confirmación | 25
7.5. Correspondencia entre eje de vuelo, zona anatómica y parámetros del canal
háptico | 25
7.6. Desglose de tiempos de ejecución de un ciclo completo de programa | 26

iii

## Lista de Acrónimos

ADC Analog to Digital Converter. 5, 7, 13, 14 BLE Bluetooth Low Energy. 6
DAC Digital to Analog Converter. 8
IMU Inertial Measurement Unit. 1, 5, 6, 10, 13, 15, 22

iv

## Índice

Agradecimientos | I
Lista de Figuras | II
Lista de Tablas | III
Lista de Acrónimos | III
1. Introducción | 1
2. Generación de sensación táctil en la zona palmar de la mano | 2
3. Interfaz hardware | 5
4. Procesamiento de datos: orientación espacial | 10
5. Procesamiento de datos: flexión de los dedos | 13
6. Estudio de percepción de sensación táctil | 17
7. Aplicación del sistema: control de un dron con feedback háptico | 21
8. Conclusiones y trabajo futuro | 27

v

Bibliografía | 28
A. Repositorio de Git-Hub | I
B. GUI de control del dron | II

vi

## 1 Introducción

La progresiva miniaturización de la electrónica y el aumento de la capacidad de procesamiento en sistemas embebidos han impulsado el desarrollo de nuevas formas de interacción entre humanos y dispositivos tecnológicos. En particular, las interfaces hápticas han cobrado especial relevancia en los últimos años, al permitir añadir el sentido del tacto como canal de comunicación con sistemas digitales, complementando los tradicionales estímulos visuales y auditivos. Esta tendencia resulta especialmente interesante en aplicaciones de realidad virtual, teleoperación, asistencia a la discapacidad y control gestual avanzado.
Dentro de este marco, el presente Trabajo Fin de Máster se plantea como una continuación directa del Trabajo Fin de Grado llevado a cabo por Jorge Cuartero [1], en el que se abordó una primera aproximación al uso de sistemas vestibles para la captura del movimiento de la mano y su utilización como interfaz de control remoto mediante un dataglove. A partir de esa base inicial, el objetivo actual consiste en avanzar hacia una integración más completa del sistema, incorporando retroalimentación háptica mediante estimulación electrotáctil y mejorando tanto el procesamiento embebido como la conectividad inalámbrica del dispositivo.
El núcleo del desarrollo se centra en un guante háptico capaz de combinar adquisición de movimiento, procesamiento local de datos y generación de sensaciones táctiles en la mano del usuario. Para ello se emplea un microcontrolador con capacidad de comunicación inalámbrica, una unidad de medida inercial (Inertial Measurement Unit (IMU)) para la estimación de la orientación espacial y un sistema de estimulación eléctrica diseñado para generar sensaciones referidas en la zona palmar sin obstaculizar la manipulación natural de objetos. Así, se consigue mantener funcionalidad manual a la misma vez que se introduce un canal adicional de información sensorial.
El sistema resultante pretende servir como plataforma experimental para el estudio de interfaces hápticas portables y su aplicación a tareas de control e interacción virtual. La combinación de procesamiento embebido, adquisición sensorial y estimulación táctil en un único dispositivo portátil abre la puerta a interfaces más naturales, compactas y eficientes, donde parte del procesamiento se realiza localmente, reduciendo latencias y mejorando la autonomía del sistema.
A lo largo de la memoria, primeramente, se presenta el fundamento del sistema de estimulación electrotáctil y los criterios de diseño adoptados para lograr sensaciones localizadas en la mano. Después se describe el hardware del dispositivo, incluyendo el microcontrolador, la instrumentación sensorial y la electrónica necesaria. A continuación, se detalla el procesamiento de los datos de orientación y la integración de la información adquirida, junto con la caracterización experimental del sistema háptico. Finalmente, como aplicación del trabajo, se implementa el guante como un sustituto del mando de control de un dron, usando la comunicación inalámbrica brindada por el microcontrolador y empleando la parte háptica como un canal de información para conocer la telemetría del dron sin usar pantallas. Para concluir, se entabla una discusión de las limitaciones actuales y posibles líneas futuras de desarrollo.

## 2 Generación de sensación táctil en la zona palmar de la mano

Para poder crear sensación táctil en la mano, el objetivo es estimular los nervios que la atraviesan con una corriente determinada. Tanaka et al. [2] diseñaron este sistema tratando de generar estas sensaciones en la zona palmar de la mano sin obstruir la misma, preservando así la destreza manual y la capacidad de interactuar con objetos físicos. Para lograrlo, se emplea una técnica basada en sensaciones referidas, donde la estimulación eléctrica aplicada en una zona (el dorso de la mano) provoca percepciones somatosensoriales en una zona distal (la palma).
A continuación, se describen los cinco desafíos técnicos identificados en la literatura analizada y las soluciones de diseño implementadas para alcanzar una estimulación precisa en 11 puntos de la zona palmar.

Desafío 1: Selección del punto de estimulación anatómica: Aunque los nervios mediano y cubital recorren el antebrazo y la muñeca, la estimulación en estos puntos se ve limitado debido a que los nervios se encuentran agrupados o empaquetados. Esto impide la activación selectiva de dedos individuales sin generar interferencias entre ellos.
Se optó por situar los electrodos en el dorso de la mano, ya que tras cruzar la muñeca, los nervios digitales se ramifican hacia cada dedo de forma independiente, haciendo posible un control individualizado. Esta diferencia anatómica en la distribución de los nervios se ilustra en la Figura 2.1.

Desafío 2: Profundidad de penetración de la corriente Una disposición convencional de electrodos (ánodo y cátodo próximos sobre el dorso) resulta ineficaz, ya que la corriente fluye de forma superficial, estimulando solo los nervios dorsales. El principio físico aplicado aquí es que la profundidad de penetración de la corriente es proporcional a la distancia entre los electrodos. Para alcanzar los nervios palmares desde el dorso, se diseñó un sistema con una gran distancia inter-electrodo, permitiendo que la corriente atraviese de manera transversal el tejido de la mano. Esta elección de diseño se ilustra en la Figura 2.1.

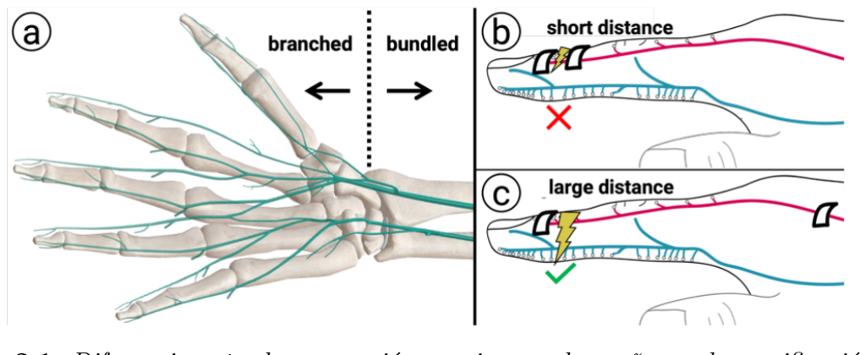
[picture p13: figure]

Figura 2.1. Diferencia entre la agrupación nerviosa en la muñeca y la ramificación en el dorso de la mano para la estimulación individual de dedos. Adaptado de [2].

Desafío 3: Asimetría sensorial y umbrales de estimulación La estimulación desde el dorso activa teóricamente tanto la zona dorsal como la palmar, lo que podría generar sensaciones confusas. Para resolver este conflicto, se aprovecha la diferencia entre número de neuronas que tienen las distintas partes de la mano: la zona palmar posee aproximadamente 18,000 mecanorreceptores, frente a solo 300 en la zona dorsal. Aprovechando esta diferencia, al calibrar la intensidad de la corriente, es posible superar el umbral de percepción palmar manteniéndose por debajo del umbral dorsal, haciendo que la sensación en la palma sea la única percibida por el usuario (ver Figura 2.2).

Desafío 4: Focalización de la sensación y polaridad Se observó que los electrodos situados en el dorso de los dedos generan sensaciones desplazadas (offset) respecto a la ubicación deseada en la palma; específicamente, no lograban estimular las falanges distales. La solución implementada consistió en la manipulación de la polaridad. Mientras que la estimulación anódica es el estándar, se implementó una inversión a estimulación catódica para los electrodos de las falanges distales. Esto permite adelantar la ubicación de la sensación hacia la punta de los dedos, permitiendo la estimulación precisa del pulpejo desde el dorso.

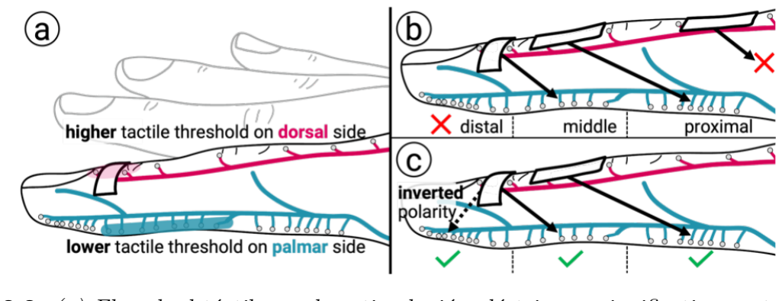
[picture p14: figure]

Figura 2.2. (a) El umbral táctil para la estimulación eléctrica es significativamente más bajo en el lado palmar que en el lado dorsal. (b, c) El uso de ambas polaridades (anódica y catódica) para el electrodo fijado a la punta del dedo permite la estimulación del pulpejo.

Desafío 5: Mitigación de interferencias inter-digitales Debido a que el nervio mediano inerva los dedos pulgar, índice y medio, mientras que el nervio cubital (ulnar) inerva el anular y meñique, el uso de un único electrodo de tierra general provocaba sensaciones referidas no deseadas en dedos adyacentes.
El diseño final solventa este problema mediante el uso de dos electrodos de tierra independientes, uno para cada nervio. Al conmutar el flujo de corriente hacia la tierra correspondiente según el dedo objetivo, se logra una selectividad total, resultando en un sistema capaz de generar sensaciones en 11 puntos diferenciados de la mano sin obstrucción palmar alguna, tal como se detalla en el esquema de la Figura 2.3.

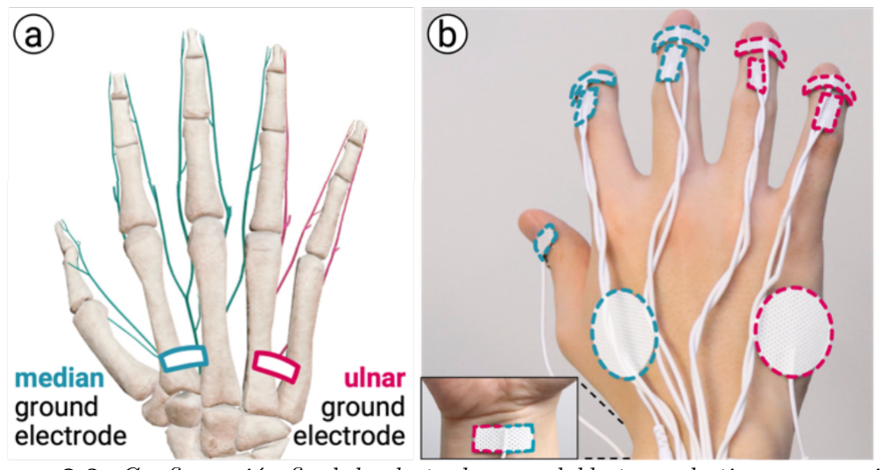
[picture p15: figure]

Figura 2.3. Configuración final de electrodos con doble toma de tierra para evitar interferencias entre los nervios mediano y cubital.

## 3 Interfaz hardware

El sistema completo para poder llevar a cabo el objetivo propuesto se monta en un guante, que se muestra en la Figura 3.1. Se distinguen los siguientes componentes: en cada dedo, del anular al meñique, sujetas por unas pequeñas piezas, fijamos bandas piezorresistivas que nos permitirán determinar su flexión. En la parte inferior se encuentra la PCB, capaz generar corrientes controladas por voltaje y programadas mediante un potenciometro digital. En la parte inferior de la placa, se encuentran los conectores hembra donde se introducen los electrodos conectados a la mano. La información proporcionada por las bandas se introduce en un Raspberry RP2040 Connect, alojado en una caja central fijada a la muñeca. A la misma vez, este dispositivo se encarga de la generación de señales eléctricas que pasan por la PCB.

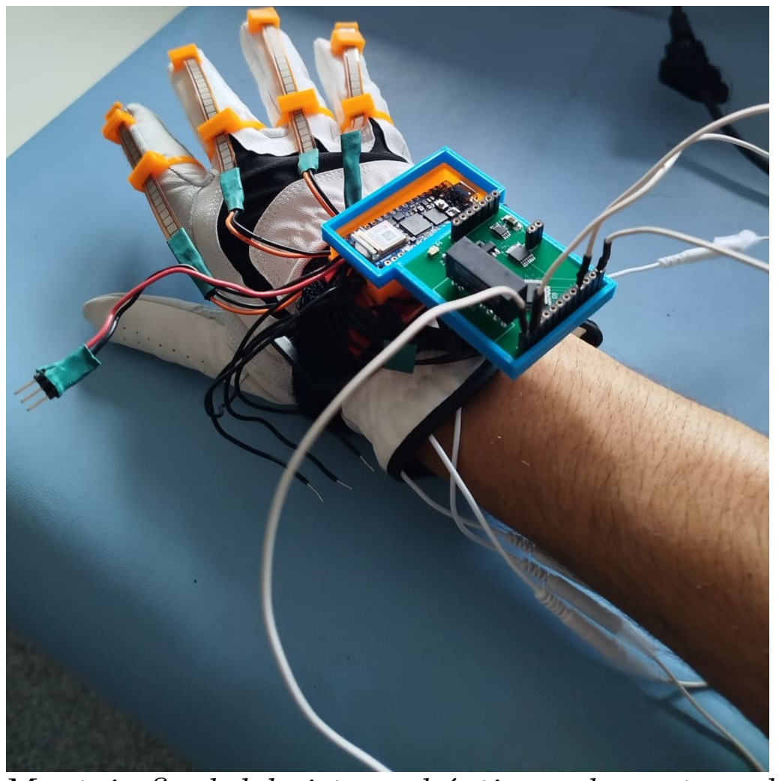
[picture p16: figure]

Figura 3.1. Montaje final del sistema háptico y de captura de movimiento

### 3.1. Arduino Nano RP2040 Connect

El microcontrolador usado para el trabajo será un módulo Arduino RP2040 Connect [3], que incorpora un microcontrolador Raspberry Pi Pic. Este controlador proporciona una gran potencia de cálculo, un factor que será relevante en el procesamiento de datos que se llevará a cabo para la estimación de la orientación. Además tiene un modulo wifi, que se usará para la comunicación en la interfaz de control en la sección 7.
En cuanto a las especificaciones generales, el RP2040 Connect opera a 3.3 V. Consta de un microcontrolador Raspberry Pi Pico (133 MHz de reloj, 256 kB de memoria SRAM) con 8 entradas analógicas (configuradas como convertidores analógico-digitales o Analog to Digital Converter (ADC), de las que 4 estarían destinadas a la adquisición de las posiciones de los dedos. Cuenta además con una IMU de 6 ejes, modelo LSM6DSOXTR [4].

### 3.1.1. Módulo LSM6DSOXTR

Este módulo [4] consta de un acelerómetro y un giróscopo, proporcionando así información de 6 ejes (3 de aceleración y 3 de rotación espacial). Aunque ambos pueden operar a distintos fondos de escala y resoluciones, la librería utilizada (Arduino_LSM6DSOX [5]) viene configurada con una sensibilidad de 0.122 mg/LSB (siendo g la aceleración de la gravedad y LSB el bit menos significativo o Least Significant Bit) para el acelerómetro y una sensibilidad de 0.07 dps/LSB para el giróscopo (donde dps son Degrees per second, grados por segundo), valores adecuados para nuestra aplicación (menores que el propio ruido). Esta librería dispone de dos funciones, una encargada de devolver 3 valores en representación de punto flotante para los tres ejes de la aceleración, y la otra de devolver los 3 valores referentes a la velocidad de rotación en cada eje en el mismo formato.
La frecuencia de medida está fijada en 104 Hz de manera predeterminada por la librería LSM6DSOX. Aunque una alta frecuencia de muestreo era importante para la estimación de la orientación mediante integración del giroscopio [1], para el método que se utilizará en este trabajo con esta tasa de muestreo se obtendrá un resultado que no se verá limitado por este valor. De todos modos, con esta configuración un ciclo de medida y procesado de nuestro Arduino no podrá durar más de 10 para que no se solapen medidas de la IMU, forzando a optimizar los tiempos de cada parte del procesado.

### 3.1.2. Módulo de conectividad inalámbrica NINA-W102

La comunicación inalámbrica del guante se implementa a través del módulo u-blox NINA-W102 [6], integrado directamente en la placa Arduino Nano RP2040 Connect. Su arquitectura interna aloja un microprocesador de doble núcleo ESP32 dedicado en exclusiva a la gestión de la pila de protocolos de red, lo que descarga completamente al procesador principal RP2040 de esta tarea y preserva su capacidad de cómputo para el procesamiento de la IMU, la lógica de control y el sistema háptico.
El módulo soporta tanto Bluetooth Low Energy (BLE) como Wi-Fi (802.11 b/g/n a 2.4 GHz). Para este diseño se ha optado por Wi-Fi, ya que el volumen de datos a transmitir (orientación de la IMU más flexión de los cuatro dedos en tiempo real) exige un ancho de banda que BLE no puede garantizar sin introducir retardos en el lazo de control con el entorno virtual, a parte de qué usar Wi-Fi será imprescindible debido a las caracteristicas del dron que se operará en la sección 7.

### 3.2. Sistema de adquisición de posiciones de la mano

El sistema de determinación de la flexión de los dedos se basa en las bandas piezorresistivas antes mencionadas. Una piezorresistencia es un material o componente que, bajo un esfuerzo mecánico, sufre un cambio en su resistividad. En nuestro caso se usarán los Flex Sensor de Spectra Symbol [7], caracterizados por valores nominales entre 7 kΩ y 13 kΩ en reposo, de forma que al ser dobladas, como mínimo duplican su valor resistivo. Como el Arduino no puede medir directamente resistencias, en [1] se implementó un circuito auxiliar que permite traducir estos cambios en tensión.
Este circuito consiste en un divisor resistivo formado por una resistencia fija (Rfija) en serie con el elemento piezorresistivo (Rpiezo), alimentado a los 3.3 V proporcionados por el propio microcontrolador. De este modo, las variaciones de resistencia de los sensores se transforman en variaciones de voltaje según la relación:

Vdivisor(Rpiezo) = 3,3 ·

Rfija
Rpiezo + Rfija

(3.1)

Para maximizar el rango de oscilación de la tensión de salida y optimizar la precisión de la lectura, el valor de Rfija se calcula para cada sensor mediante la media geométrica de sus extremos resistivos:

Rfija =

p

Rmax · Rmin | (3.2)
donde Rmax y Rmin representan las resistencias máxima y mínima medidas en flexión (pico) y extensión (relajado), respectivamente. En el montaje real, se seleccionan los valores comerciales de resistencia fija más cercanos a los óptimos teóricos calculados para el rango de cada dedo. El cálculo con los valores que finalmente se usan en el dataglove se detallan en el anexo de [1].
La tensión de salida del divisor se introduce en los pines analógicos del microcontrolador, configurados como entradas del ADC. Este convertidor opera con una resolución de 10 bits (lo que genera un rango digital de 0 a 1023 cuentas) y un rango de tensión de 0 a 3.3 V, lo que resulta en una resolución de medida de 3.2 mV. Además, el tiempo de adquisición es inferior a 30 µs, lo que cumple holgadamente con los requisitos de velocidad y tasa de muestreo exigidos para completar un ciclo de nuestro proceso.

### 3.3. Circuito de estimulación electrotáctil

Para poder conseguir estimular los nervios de la mano y generar sensación táctil, según la bibliografía existente en el ámbito [2], la corriente generada debe ser del orden de pocos miliamperios y, al mismo tiempo, de suficiente tensión como para superar la impedancia de la piel, que según medidas rápidas tomadas en el laboratorio esta en torno al megaohmio. Además, según el sistema de electrodos descrito en la sección 2, debe poder conmutar entre 10 canales de estimulación y cambiar entre corriente catódica y anódica según lo requiera la configuración correspondiente, por lo que teniendo todo esto en cuenta el circuito finalmente construido será el de la Figura 3.2:

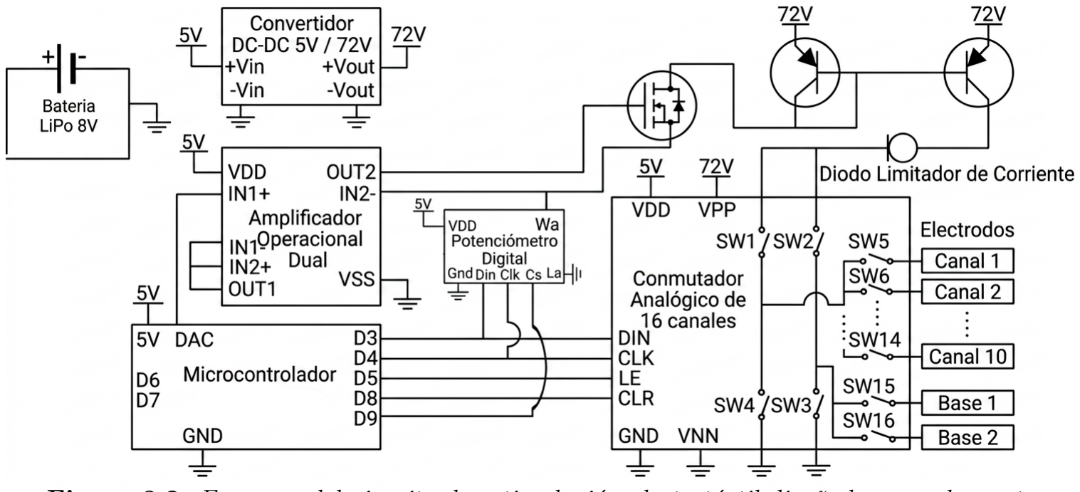
[picture p17: figure]

Figura 3.2. Esquema del circuito de estimulación electrotáctil diseñado para el guante.
A diferencia de los diseños previos de la literatura que dependían de reguladores elevadores intermedios y baterías de baja tensión [2], este circuito se alimenta directamente a través de la batería de 7.4 V con una capacidad de almacenamiento de energía de 1000 mAh conectada al pin Vin del Arduino Nano RP2040 Connect, colocando en el cable que sale a alimentar el sistema un regulador a 5 V constantes. Para la etapa de estimulación, la generación de la alta tensión de 72 V se confía a un convertidor DC-DC modelo NMT0572SC, el cual se alimenta con esta salida regulada de 5 V.
Como este microcontrolador no tiene una salida Digital to Analog Converter (DAC), para controlar de manera precisa la intensidad de los impulsos electrotáctiles y adaptarla a los umbrales sensitivos del usuario, se ha sustituido el potenciómetro analógico manual por un potenciómetro digital MAX5413. El microcontrolador gobierna este dispositivo mediante un protocolo basado en SPI, optimizando el uso de pines al compartir las líneas de datos DIN y de reloj CLK con el circuito integrado de conmutación de alta tensión HV2701, requiriendo únicamente una línea adicional para la selección de chip el potenciometro (CS*). La señal digital del microcontrolador se hace pasar por este potenciómetro y se introduce en un amplificador operacional LMV341 conectado a un FET BSS87, configurando una fuente de corriente controlada por voltaje para independizar la señal de la carga. Acto seguido, un espejo de corriente basado en transistores bipolares BJT FCX705 replica esta corriente de referencia y la transfiere hacia la línea de alta tensión (72 V), asegurando un flujo eléctrico constante.
La señal de corriente regulada por esta etapa se inyecta en el conmutador analógico de alta tensión HV2701. Este circuito integrado multiplexa la señal hacia los 10 canales disponibles en la mano y las dos tomas de tierra independientes (Base 1 y Base 2), encargadas de aislar los nervios mediano y cubital. Internamente, una matriz de interruptores actúa a modo de puente en H para invertir dinámicamente la polaridad de la estimulación (catódica o anódica) según los requerimientos específicos de la zona palmar seleccionada.
Debido a la arquitectura del sistema, se aplica una técnica de multiplexación temporal para mitigar las interferencias; de este modo, el integrado HV2701 solo habilita un camino de corriente hacia un único objetivo simultáneamente. Dado que este integrado es capaz de conmutar entre canales en un tiempo de apenas 10 µs, el firmware del Arduino completa un ciclo secuencial para todos los canales en un intervalo inferior a 10 ms. Puesto que el umbral de discriminación temporal del sentido del tacto humano se sitúa en torno a los 50 ms, el usuario percibe la activación de múltiples puntos de la mano de forma totalmente concurrente a frecuencias de hasta 100 Hz [2].
Para dotar de seguridad al sistema y evitar accidentes se integra en serie un diodo limitador de corriente (E-452) que actúa como limitador físico si la corriente de salida llega a alcanzar los 4.5 mA, garantizando la inocuidad del guante ante cualquier fallo de ejecución en el microcontrolador. Por último, todo este diseño electrónico se ha plasmado en una PCB que fue diseñada mediante el software KiCad y posteriormente enviada a fabricar para su ensamblaje final, diseño y resultado que se pueden ver en la Figura 3.3.

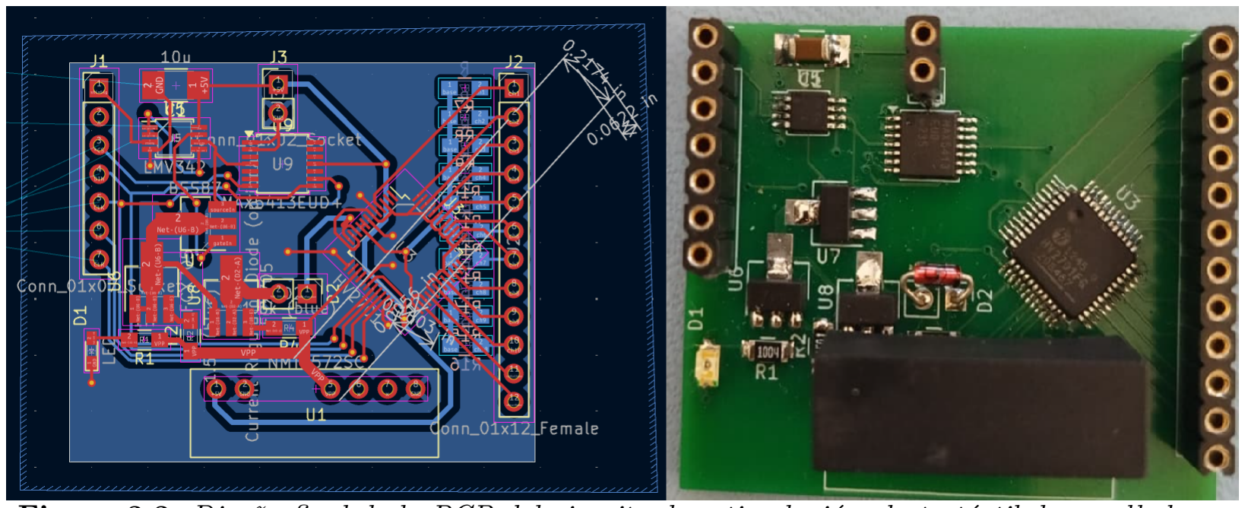
[picture p18: figure]

Figura 3.3. Diseño final de la PCB del circuito de estimulación electrotáctil desarrollado en KiCad y resultado final una vez se recibió de la fábrica. Agradecimientos a Diego Antolín por su ayuda con el diseño y a Óscar Lasarte por montar la placa.

## 4 Procesamiento de datos: orientación espacial

El núcleo del procesamiento de datos de la IMU LSM6DSOXTR reside en la estimación precisa de la orientación del sensor. Anteriormente, se planteaba el sistema de ecuaciones para obtener la expresión de los ángulos de Euler de la orientación, pero haciendo esto, una de las ecuaciones debe de integrar en el tiempo dos de los ejes del giroscopio. Con este método el procesamiento inducia en deriva de uno de los ángulos de manera inevitable [1]. Para este trabajo, se ha implementado un filtro complementario no lineal propuesto por Mahony et al. [8], el cual formula el problema de estimación como una cinemática de observador determinista directamente sobre el grupo ortogonal especial SO(3). Este método utiliza la geometría del grupo de Lie para desacoplar las mediciones del giroscopio del error de actitud reconstruido, buscando una implementación lo más eficiente posible para el hardware disponible.

### 4.1. Representación de la orientación: cuaterniones

Antes de formular el filtro, es necesario elegir cómo representar matemáticamente la orientación del sensor en el espacio tridimensional. La opción más intuitiva son los ya mencionados ángulos de Euler: guiñada ψ (yaw), cabeceo θ (pitch) y alabeo φ (roll). Estos presentan una singularidad conocida como gimbal lock cuando dos ejes de rotación se alinean, además de requerir funciones trigonométricas computacionalmente costosas para el RP2040. Por ello, el filtro opera internamente con cuaterniones unitarios, una representación algebraica que evita estas singularidades y permite actualizar la orientación mediante operaciones aritméticas simples.
Un cuaternión unitario q queda definido como:

q =

q0
q1
q2
q3
, | kqk = 1, | (4.1)

donde q0 es la parte escalar, asociada al ángulo de rotación, y (q1, q2, q3) es la parte vectorial, asociada al eje de rotación. La condición de unitariedad garantiza que el cuaternión represente siempre una rotación pura, sin escalado. Cuando se requiere expresar la orientación final en ángulos de Euler para enviarlos al entorno de control, la conversión se realiza a posteriori, de forma que todo el procesamiento interno permanece libre de singularidades.

### 4.2. Fusión de acelerómetro y giroscopio

El giroscopio proporciona la velocidad angular ω, que integrada en el tiempo permite seguir la evolución de la orientación con gran precisión a corto plazo. Sin embargo, cualquier sesgo (bias) estático o deriva lenta en sus lecturas se acumula en la integral, generando un error de orientación que crece sin límite con el tiempo. El acelerómetro, por su parte, mide la aceleración total del sensor; cuando el guante no está sometido a aceleraciones externas apreciables, esta medida queda dominada por la gravedad terrestre, cuya dirección es conocida en el marco inercial. Esto permite obtener una referencia absoluta de inclinación, libre de deriva, aunque ruidosa en presencia de movimientos bruscos.
El filtro de Mahony se basa en la complementariedad de ambos sensores: el giroscopio proporciona una estimación dinámica y precisa a corto plazo, mientras que el acelerómetro corrige continuamente la deriva a largo plazo. Para cuantificar cuánto difiere la orientación estimada de la real se define un error vectorial e mediante el producto vectorial entre la dirección de la gravedad medida por el acelerómetro normalizada y la dirección de la gravedad que el cuaternión actual predice en el marco del sensor [8]:
e = aˆ × v, | (4.2)
donde aˆ = a/kak es la aceleración normalizada y v es la estimación de la dirección de la gravedad obtenida rotando el vector [0, 0, 1]T

con el cuaternión actual:

v =

2(q1q3 − q0q2)
2(q0q1 + q2q3)
q

2
0 − q

2
1 − q

2
2 + q

2
3
- . | (4.3)

El producto vectorial produce un vector cuya dirección es el eje en torno al cual debe corregirse la estimación y cuya magnitud es proporcional al ángulo de error. Cuando ambos vectores coinciden, el error es nulo y el filtro no introduce ninguna corrección. Por lo tanto, esta formulación evita la reconstrucción algebraica completa de la actitud, ya que el error se calcula directamente en el espacio del sensor sin pasar por ángulos de Euler.

### 4.3. Controlador PI y corrección del bias

El error e se utiliza para corregir la velocidad angular antes de integrarla, mediante un controlador proporcional-integral (PI) clásico. La acción proporcional, escalada por la ganancia Kp, reacciona inmediatamente al error presente; la acción integral, escalada por

Ki

, acumula el error a lo largo del tiempo y compensa el sesgo estático del giroscopio:

eint(t) = eint(t − ∆t) + Ki e ∆t, | (4.4)
ωc = ω + Kpe + eint. | (4.5)
La velocidad angular corregida ωc se usa para propagar el cuaternión en el tiempo. La cinemática diferencial del cuaternión unitario establece que:

q˙ =

1
2

q ⊗

0
ωc
, | (4.6)
donde ⊗ denota el producto de cuaterniones. Discretizando mediante integración de Euler con paso ∆t:

qk+1 = qk +

1
2
qk ⊗ (0, ωc) ∆t, | (4.7)
lo que, expandido en sus cuatro componentes, resulta en:

q0 ← q0 −

∆t
2

(q1gx + q2gy + q3gz),

q1 ← q1 +

∆t
2

(q0gx + q2gz − q3gy),

q2 ← q2 +

∆t
2

(q0gy − q1gz + q3gx),

q3 ← q3 +

∆t

(q0gz + q1gy − q2gx), | (4.8)

donde (gx, gy, gz) son las componentes de ωc. Estas operaciones son básicamente sumas y multiplicaciones de enteros en punto flotante, sin funciones trigonométricas, lo que hace al algoritmo sea adecuado para el RP2040. Tras cada iteración, el cuaternión se renormaliza para mantener la condición de unitariedad y evitar la acumulación de errores numéricos:

q ←

q
kqk
. | (4.9)
La estabilidad de este esquema de corrección fue demostrada por Mahony et al. [8] mediante un análisis de Lyapunov. Utilizando como función candidata la traza de la matriz de error de orientación y el módulo del bias estimado, se prueba que su derivada temporal es semidefinida negativa, lo que garantiza la convergencia casi global del error de orientación a cero y del bias estimado hacia su valor real.

### 4.4. Calibración inicial y recentrado dinámico

Al encender el guante, antes de comenzar la estimación en régimen permanente, se realiza una fase de calibración en la que el sistema se mantiene en reposo durante la adquisición de N = 100 muestras de velocidad angular. El bias inicial del giroscopio se estima como la media de dichas muestras:

bω =

1
N

X

N

i=1

ωi

, | (4.10)

y a partir de ese instante, toda medida angular se corrige sustrayendo este valor antes de introducirlo en el filtro. Esta calibración reduce el error inicial del controlador integral, acelerando la convergencia del filtro.
Además del sesgo del giroscopio, existe un segundo problema práctico: la orientación física del guante en el momento de encendido puede ser arbitraria, lo que haría que el entorno virtual comenzara siempre en una postura diferente. Para resolverlo, una vez completada la calibración se captura el cuaternión resultante como referencia de postura neutra, calculando su conjugado:
qoff = (q0, −q1, −q2, −q3). | (4.11)
A partir de ese momento, la orientación transmitida al entorno de control no es q sino la orientación relativa al instante de referencia, obtenida mediante el producto:
qrel = qoff ⊗ q. | (4.12)
Este recentrado garantiza que el sistema arranque siempre en una postura neutra definida por el usuario, independientemente de la orientación física inicial del guante, simplificando enormemente la puesta en marcha y haciendo el dispositivo robusto frente a variaciones en la colocación del guante entre sesiones.

## 5 Procesamiento de datos: flexión de los dedos

A diferencia del bloque anterior, orientado al tratamiento de los datos de la IMU, este apartado describe el procesamiento de la información procedente de los divisores piezorresistivos para la determinación de la posición de los dedos. Como se adelantó en la introducción, esta tarea se delega en un módulo de inteligencia artificial embebido, ya que aunque sería factible establecer umbrales fijos para cada posición, las herramientas actuales de despliegue de modelos neuronales sobre microcontroladores ofrecen soluciones más flexibles, robustas frente a la variabilidad entre sesiones y computacionalmente ligeras. Una red neuronal es un conjunto de nodos interconectados que, al recibir una serie de valores de entrada, los transforma a través de sucesivas capas de procesamiento hasta producir una salida. El interés de estas redes reside en su capacidad de ajustar los pesos de sus conexiones durante un proceso de entrenamiento, en el que se le presentan ejemplos etiquetados y la red modifica iterativamente sus parámetros para minimizar el error entre su salida y la respuesta esperada. Para el reconocimiento de posiciones de la mano, se emplea una arquitectura fully connected, en la que todos los nodos de una capa conectan con todos los nodos de la siguiente, tal como se ilustra en la Figura 5.1.

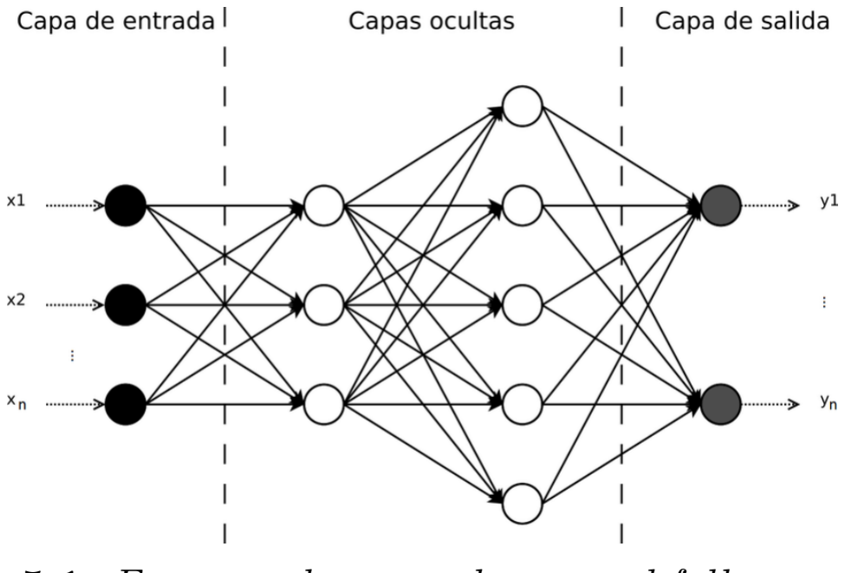
[picture p19: figure]

Figura 5.1. Esquema de una red neuronal fully connected. El proceso de ajuste se lleva a cabo con TensorFlow [9], una librería de Python de código abierto desarrollada por Google que proporciona herramientas de alto nivel para la definición, entrenamiento y exportación de modelos neuronales. Aun así, antes de definir la arquitectura de la red hay que recopilar una serie de datos que formaran el conjunto de entrenamiento.

### 5.1. Dataset

El dataset es el conjunto de ejemplos etiquetados a partir del cual la red aprende a asociar cada combinación de lecturas sensoriales con la posición correcta de la mano. En este trabajo, las entradas de la red son los dos valores del ADC correspondientes a los dedos índice y corazón, únicos sensores piezorresistivos destinados al reconocimiento de postura. Los dedos anular y meñique se reservan para funciones de control independientes descritas en la sección 7, por lo que sus lecturas no forman parte del clasificador.
La salida de la red es un identificador de posición codificado como un entero entre 0 y 8, correspondiente a las 9 posiciones representadas en la Figura 5.2. Esta reducción respecto al trabajo previo, donde se usaban más dedos [1], podría suponer una limitación, pero en ciertos aspectos aporta ventajas sobre la red neuronal: con solo 2 entradas en lugar de 4, el espacio de estados que la red debe aprender es considerablemente más reducido, lo que permite alcanzar precisiones elevadas con arquitecturas más pequeñas, menor tiempo de inferencia en el microcontrolador y menor riesgo de sobreajuste durante el entrenamiento. Además, al disponer de un número de clases ligeramente menor (9 frente a 10), el problema de clasificación resulta intrínsecamente más sencillo, especialmente porque se eliminan algunas de las posiciones más similares entre sí que generan mayor confusión en la red.

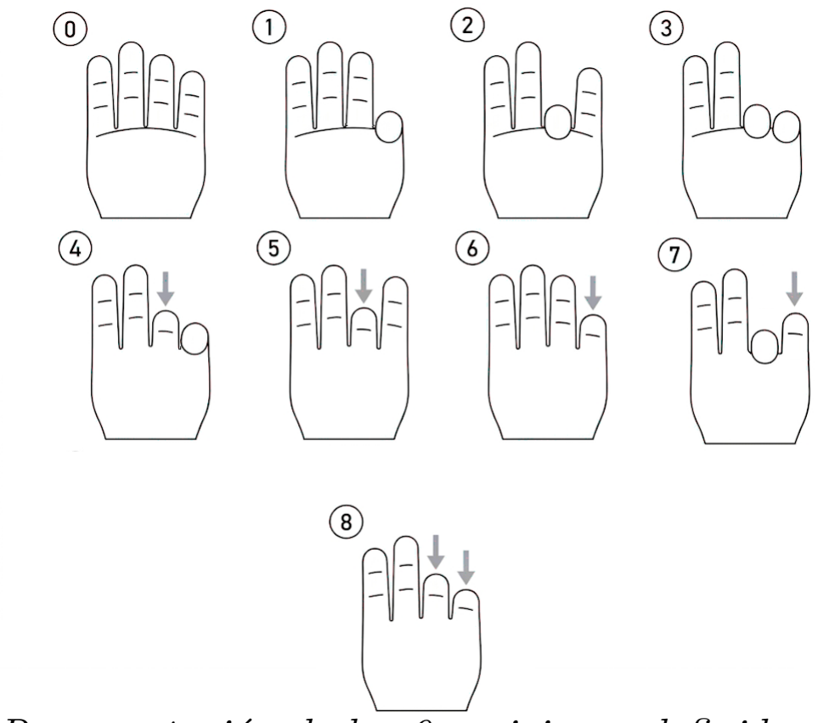
[picture p20: figure]

Figura 5.2. Representación de las 9 posiciones definidas para el dataset.
Para la adquisición de los datos se desarrolló un programa que, cada vez que se pulsa enter, solicita al usuario que adopte una de las posiciones indicadas y almacena las lecturas de los sensores en un fichero de texto. Con el fin de dotar a la red de la mayor robustez posible frente a variaciones en la colocación del guante o en las condiciones de uso, el dataset se tomó a lo largo de varios días distintos, introduciendo así dispersión natural debida a ligeras diferencias en la posición del guante sobre la mano o en la postura del brazo.
El conjunto de datos resultante cuenta con aproximadamente XXX muestras por posición, distribuidas de forma uniforme entre las 9 clases para evitar sesgos durante el entrenamiento, como puede comprobarse en la Figura 5.3. En cuanto al reparto, el 80 % de los datos se destinan al entrenamiento, el 10 % a la validación y el 10 % restante al test, seleccionados de forma aleatoria.
Figura 5.3. Histograma del número de muestras por posición en el dataset.

Figura 5.4. Gráficos de cajas y bigotes que muestran la distribución de los valores del ADC para cada dedo en cada posición del dataset. Por conveniencia, los valores del dataset se escalan acotando todas las lecturas entre 0 y 1 respecto a los extremos registrados durante una calibración previa. Esta normalización garantiza que, aunque existan ligeras variaciones en el funcionamiento de los sensores entre sesiones o diferencias en la colocación del guante, el clasificador opere siempre sobre el mismo rango de entrada, preservando su precisión en el uso cotidiano.

### 5.1.1. One-hot encoding

Dado que se trata de un problema de clasificación multiclase, la salida de la red se codifica mediante one-hot encoding [10]. En lugar de representar cada posición como un único entero, la red cuenta con 9 salidas, una por clase, y proporciona como resultado un vector de probabilidades cuya componente de mayor valor indica la posición estimada. Para ello, cada etiqueta numérica del dataset se sustituye por un vector de 9 elementos con un 1 en la posición correspondiente y 0 en el resto. Así, por ejemplo, la posición 0 (mano abierta) queda codificada como 100000000, mientras que la posición 3 se representaría como 000100000.
En la capa de salida, esta codificación se asocia habitualmente a la función de activación softmax, que mapea el vector de salida al simplex de probabilidades garantizando que la suma de todas las componentes sea la unidad (Figura 5.5a). Sin embargo, esta función no está implementada en la librería empleada para la exportación del modelo al microcontrolador. Por ello se sustituye por la función ReLU (Figura 5.5b), presente en el resto de capas de la red, cuya sencillez la hace especialmente eficiente en hardware embebido. Aunque con esta sustitución se pierde la interpretación probabilística estricta de la salida, los resultados experimentales obtenidos resultan igualmente satisfactorios.
Figura 5.5. Funciones de activación empleadas en la red: (a) Softmax, usada habitualmente en la capa de salida de clasificadores multiclase. (b) ReLU, empleada en todas las capas de la red final.

### 5.2. Entrenamiento y selección de la arquitectura

El objetivo del proceso de entrenamiento es encontrar la red de menor tamaño posible que mantenga una precisión próxima al 100 %, ya que una red más compacta ocupa menos memoria en el microcontrolador y reduce el tiempo de inferencia, aspecto crítico dado el ciclo de 10 ms impuesto por la tasa de muestreo de la IMU.
La red se fija en 4 capas: una capa de entrada de 2 neuronas, dos capas ocultas de tamaño variable y una capa de salida de 9 neuronas. Se exploran distintas configuraciones de las capas ocultas, evaluando cómo evoluciona la precisión en validación al variar el número de neuronas en la primera capa oculta con la segunda fijada en 15 neuronas (Figura 5.6). A partir de los resultados, se seleccionan únicamente las configuraciones que superan el 95 % de precisión, lo que acota el rango de arquitecturas candidatas.
Figura 5.6. Evolución de la precisión de la red en función del número de neuronas en la primera capa oculta, con la segunda capa fijada en 15 neuronas. Durante el entrenamiento se ajustan dos hiperparámetros adicionales: el número de épocas y el dropout. El número de épocas determina cuántas iteraciones completas sobre el conjunto de entrenamiento realiza el optimizador; aunque aumentarlo mejora la precisión, a partir de cierto punto la red queda atrapada en un óptimo local y deja de mejorar. El dropout mitiga este problema reiniciando aleatoriamente una fracción de los pesos entre épocas, forzando a la red a explorar nuevas soluciones y evitando el estancamiento. Con esta estrategia se alcanzan precisiones del 99 %, a costa de tiempos de entrenamiento algo más prolongados.

### 5.3. Compresión e integración con TensorFlow Lite

Una vez seleccionada la arquitectura óptima, el modelo se exporta al microcontrolador mediante TensorFlow Lite [11] y su adaptación para Arduino, la librería Eloquent [12]. El proceso de compresión consta de dos etapas: en primer lugar, se congelan todos los pesos de la red convirtiéndolos de variables a constantes y se elimina la arquitectura de entrenamiento, conservando únicamente la parte de inferencia; en segundo lugar, los parámetros se cuantifican de punto flotante de 32 bits a punto fijo de 8 bits, reduciendo drásticamente el tamaño del modelo en memoria.
El resultado de la compresión es un fichero .h que se incorpora directamente al programa del Arduino. Dado que la cuantificación puede degradar la precisión, se evalúan todas las redes candidatas tras la compresión para identificar cuáles mantienen su rendimiento. Se observa que las configuraciones con menor número de neuronas presentan una mayor pérdida de precisión al comprimir, especialmente en la distinción de posiciones similares entre sí. En cuanto a los tiempos de inferencia, la diferencia entre la red más pequeña y la más grande es inferior a 0.1 ms, por lo que se adopta la red de mayor tamaño de entre las validadas, ya que ofrece la mayor robustez ante posiciones próximas sin comprometer el ciclo temporal del sistema. La arquitectura final seleccionada se muestra en la Figura 5.7.
Figura 5.7. Arquitectura de la red neuronal seleccionada tras el proceso de entrenamiento y compresión: tamaño de cada capa y número de parámetros entrenables. Complementando al clasificador, se implementa un mecanismo de confirmación de posición: el sistema solo registra un cambio de estado cuando la red predice la nueva posición de forma consistente durante un intervalo de tiempo mínimo. Dado que el ciclo de medida es de 10 ms, significativamente inferior al tiempo de reacción motora del usuario, sin este mecanismo las transiciones entre posiciones o los errores puntuales de la red generarían detecciones espurias que degradarían la experiencia de control.

## 6 Estudio de percepción de sensación táctil

Con el hardware completamente ensamblado y el firmware de control operativo, el siguiente paso antes de integrar el sistema en la aplicación final es caracterizar y validar experimentalmente el módulo de estimulación electrotáctil. Este apartado recoge, en primer lugar, la caracterización eléctrica del circuito para establecer la relación entre la configuración del potenciómetro digital y la corriente realmente inyectada en los electrodos. A partir de dicha caracterización se obtiene una curva de linealización que permite programar directamente valores de corriente desde el microcontrolador. En segundo lugar, se describe un estudio perceptivo realizado sobre el propio autor con el objetivo de evaluar la capacidad del sistema para generar sensaciones táctiles localizadas en los puntos de la mano definidos en la sección 2.

### 6.1. Caracterización de la curva de corriente

El potenciómetro digital MAX5413 admite valores de configuración P comprendidos entre 0 y 255, que el microcontrolador transmite mediante el protocolo SPI. Internamente, este dispositivo actúa como una resistencia variable en la red de polarización del amplificador operacional LMV342, de modo que el valor de P determina la resistencia efectiva R(P) del potenciómetro según la relación:

R(P) = Rm´ax ·

P
255
, | (6.1)
donde Rm´ax es la resistencia máxima del dispositivo, en este caso 10 kΩ. Dado que el amplificador operacional junto con el transistor FET configura una fuente de corriente controlada por voltaje, la corriente de salida queda determinada por la tensión en el nodo de control, que a su vez es inversamente proporcional a R(P). La corriente resultante sigue por tanto la relación:

I(P) = Cte
P
, | (6.2)
donde K es una constante que agrupa los parámetros del circuito. Esta dependencia hiperbólica implica que incrementos iguales de P no producen incrementos iguales de corriente, siendo la respuesta muy sensible a valores bajos de P y progresivamente más plana a medida que P aumenta.
Para verificar experimentalmente esta relación y cuantificar el valor de K, se conectó una resistencia de carga conocida RL = 1000 Ω entre los terminales de salida del circuito en lugar de los electrodos. Midiendo la tensión VL en bornes de la resistencia con un multímetro, la corriente se obtiene directamente como I = VL/RL. El procedimiento se repitió para varios valores de P entre 0 y 255, programando cada configuración desde el Arduino y registrando la medida correspondiente. Los resultados obtenidos se muestran en la Figura 6.1.

### 6.2. Linealización y regresión

La relación hiperbólica de la ecuación (6.2) resulta poco conveniente para el control del sistema, por lo que para obtener mediante una formula a que corriente corresponde

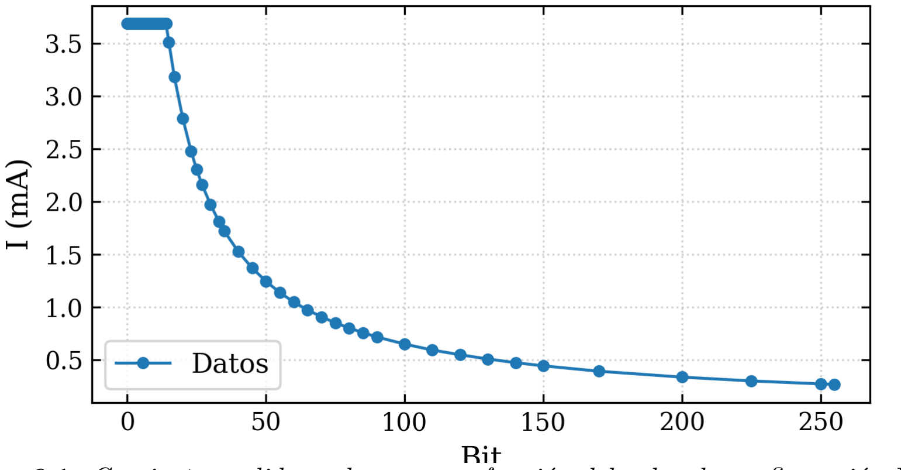
[picture p21: figure]

Figura 6.1. Corriente medida en la carga en función del valor de configuración P del potenciómetro digital. La curva presenta la forma hiperbólica I = Cte/P predicha, quitando la zona donde el diodo limitador de corriente empieza a tener efecto

cada valor de P, se procede a linealizar la curva mediante el cambio de variable y = 1/I, de modo que la relación entre corriente y variable transformada es lineal:
y = K · P | (6.3)
Sobre los datos experimentales transformados se realiza una regresión lineal por mínimos cuadrados, ajustando el modelo y = a · x + b, donde el término independiente b recoge posibles offset residuales del circuito. Los parámetros del ajuste obtenidos son:

aˆ = 0,01441 mA,

ˆb = 0,0824 mA, | (6.4)
con un coeficiente de determinación R² = 0,9999, lo que confirma la validez del modelo linealizado para describir el comportamiento del circuito en el rango de operación. Para el ajuste no se han tenido en cuenta los datos donde el diodo limitador de corriente tiene efecto. El ajuste se muestra superpuesto a los datos experimentales en la Figura 6.2.

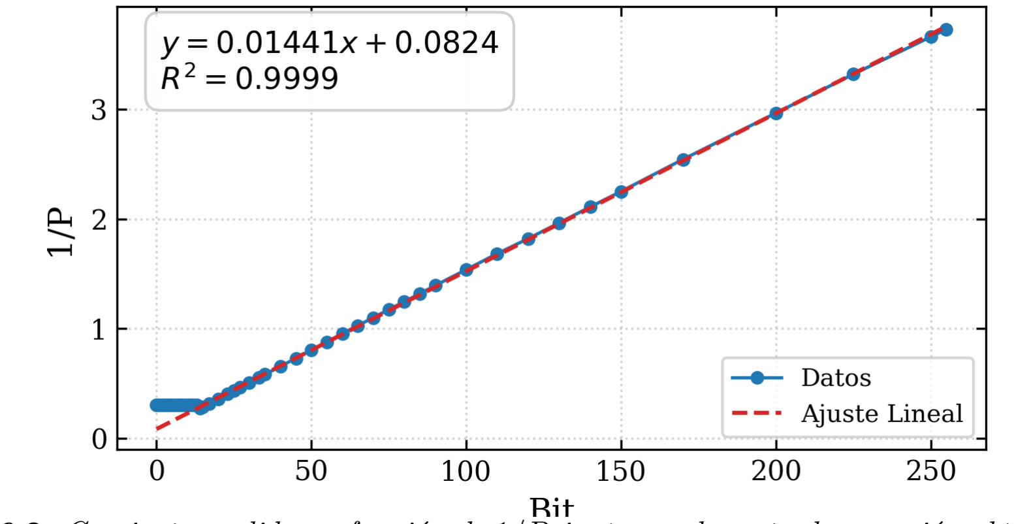
[picture p22: figure]

Figura 6.2. Corriente medida en función de 1/P junto con la recta de regresión obtenida por mínimos cuadrados. El elevado valor de R²

confirma el comportamiento lineal tras el cambio de variable.

Por lo tanto, dado un valor de P el circuito dará una corriente de salida que seguirá la ecuación 6.5:

I(P) = | 1
0, 01441 · P + 0, 0824
mA | (6.5)
que se implementa en el firmware del Arduino para traducir cualquier valor de bit programado que se envía por SPI al MAX5413 con el valor de corriente correspondiente . De este modo, el resto del sistema opera en unidades de miliamperios, desacoplando la lógica de control de los detalles del circuito analógico.
Como se observa en las dos figuras, el diodo limitador E-452 integrado en serie garantiza que, ante cualquier combinación de parámetros, la corriente que entra en el multiplexador no supere los 4.5 mA, por lo que la ecuación (6.5) solo es válida en el rango P ∈ [15, 255] mA. Los demás valores de P tendrán una corriente muy parecida a la que corresponde a P = 15

### 6.3. Estudio perceptivo

Con el circuito caracterizado, se procede a validar el sistema háptico mediante un estudio de percepción que se realizará sobre el propio autor. El objetivo será comprobar mediante un estudio rápido cuáles de los diez canales de estimulación, y con que polarización, son capaces de generar una sensación referida a la zona palmar esperada, descartando aquellos en los que la localización o la sensación no sea la correcta. Para ver los resultados conseguidos por un sistema similar pero con un número mayor de pacientes, se puede consultar la referencia [2].

### 6.3.1. Protocolo experimental

Para el estudio se emplea la señal Burst, un pulso cuadrado de 50 ms en estado activo, que produce una sensación puntual comparable a la de pulsar un botón. Para cada canal, se parte de un valor de P elevado, correspondiente a una corriente baja, y se va reduciendo progresivamente hasta que el autor detecta alguna sensación. En ese punto, se envian 5 pulsos consecutivos y se anota la zona de la mano en la que se ha percibido el estímulo. Si la zona indicada coincide con la zona palmar esperada para ese canal según el diseño de la sección 2, el canal se considera válido; en caso contrario, se descarta.

### 6.3.2. Resultados

La Tabla 6.1 recoge, para cada canal, la zona palmar objetivo, la polaridad de estimulación y el resultado del estudio. La Figura a la izquierda de la tabla muestra la correspondencia entre cada canal y su zona palmar asociada.


(a) Zonas palmares objetivo por canal.
Canal Zona objetivo | Polaridad Válido
ch1 | Pulgar | Anódica | Dorsal
| | Catódica | X
ch2 | Índice distal | Anódica | X
| | Catódica | Dorsal
ch3 | Corazón distal | Anódica | X
| | Catódica | Dorsal
ch4 | Anular distal | Anódica | X
| | Catódica | X
ch5 | Meñique distal | Anódica | X
| | Catódica | Dorsal
ch6 | Índice proximal | Anódica | X
| | Catódica | Dorsal
ch7 | Corazón proximal | Anódica | X
| | Catódica | 50/50
ch8 | Anular proximal | Anódica | X
| | Catódica | 50/50
ch9 | Meñique proximal | Anódica | X
| | Catódica | 50/50
ch10 Palma | Anódica | ×
| | Catódica | X
(b) Validación perceptiva.

Tabla 6.1. Estudio de localización del estímulo: a) Zonas palmares correspondientes a cada canal de estimulación. b) Resultado del estudio de localización para cada canal y polaridad de estimulación. La columna Válido indica si la sensación referida coincidió con la zona esperada (X), si se percibió en la zona Dorsal, si se percibió en ambas partes (50/50), o si no se percibió ninguna sensación (×). Los canales que superaron la validación concuerdan con el mecanismo de sensaciones referidas descrito en la sección 2: la estimulación aplicada en el dorso de la mano se percibe en la zona palmar correspondiente, y no en la zona dorsal donde se sitúan los electrodos. Para estos canales, se anota que la corriente promedia donde se empezó a notar sensación táctil, fue de 3,38 mA, cifra algo elevada puesto que se acerca al umbral de máxima corriente impuesto. Los canales descartados corresponden en su mayoría a zonas anatómicamente próximas entre sí, donde la separación inter-electrodo no es suficiente para aislar completamente la corriente hacia el nervio digital objetivo. Este resultado está en línea con las limitaciones del sistema de doble tierra discutidas en la sección 2, y determina el subconjunto de canales que se podrán emplear en la aplicación de control de la sección 7.

## 7 Aplicación del sistema: control de un dron con feedback háptico

Como aplicación del sistema desarrollado, para poner a prueba todo el trabajo en su conjunto, se decidió implementarlo como método de control de vuelo de un dron comercial de bajo coste, concretamente el modelo Karuisrc K417, empleando el guante como dispositivo de mando. La elección de esta plataforma responde a que el vuelo de un dron requiere gestionar de forma simultánea cuatro grados de libertad: aceleración, guiñada (yaw), cabeceo (pitch), alabeo (roll). Esto es útil para obligar a activar en paralelo todos los subsistemas del guante: la estimación de orientación mediante el filtro de Mahony, la lectura de los sensores de flexión, el reconocimiento gestual mediante la red neuronal embebida y la retroalimentación háptica electrotáctil. El resultado es un bucle de control en el que el piloto actúa sobre el dron inclinando y girando la mano, mientras usa la posición de los dedos como canal adicional de control, a la vez que el sistema le devuelve información táctil localizada sobre la maniobra que está ejecutando, sin recurrir a ningún tipo de retroalimentación visual del estado del vuelo.

### 7.1. Protocolo WiFi de control del dron

Para poder mandar ordenes al dron, se usa su punto de acceso Wi-Fi propio, pero el problema es que no dispone de documentación pública sobre su protocolo de comunicación. Para poder controlarlo desde el microcontrolador fue necesario caracterizar dicho protocolo mediante la técnica de captura de tráfico en red local. El procedimiento consistió en conectar un ordenador a la misma red inalámbrica que la aplicación para Android del dron y, mediante scripts desarrollados en Node.js y Python (disponibles en el Anexo A), interceptar y registrar todos los datagramas UDP que la app enviaba hacia la dirección IP del dron (192.168.169.1) a través del puerto 8800. Actuando sobre los controles de la aplicación de forma sistemática y observando simultáneamente cómo cambiaba el contenido de los paquetes capturados, fue posible asociar cada campo de la trama binaria a la función de vuelo correspondiente.
El análisis reveló que cada mensaje de control tiene una longitud fija de 124 bytes y está estructurado en cuatro bloques lógicos separados por campos de verificación y contadores de secuencia. La Tabla 7.1 resume la organización del datagrama identificada en este proceso.
Tabla 7.1. Estructura del datagrama UDP de 124 bytes del protocolo K417.
Bloque Contenido | Bytes Naturaleza
Cabecera Identificador de sincronización | 12 | Fijo
C1 | Ejes de control + comando + headless | 32 | Variable
Checksum Prefijo fijo + contadores de secuencia | 14 | Variable
C2 | Repetición de ejes + campos de estado | 32 | Variable
C3 | Información de estado adicional | 34 | Variable
Total | | 124

Dentro del bloque C1 se sitúan los cuatro bytes de ejes de vuelo, cada uno codificado como un entero sin signo en el rango [40, 220], donde el valor 128 representa el punto neutro. El mismo bloque alberga un byte de comando especial, que puede tomar valores

Tabla 7.2. Estructura del datagrama UDP de 124 bytes del protocolo K417.
Bloque Contenido | Bytes Naturaleza Detalle
Cabecera Identificador de sincronización | 12 | Fijo | 0xEF 0x02 0x7C … constante en
todos los paquetes

C1

| Alabeo, cabeceo, acelerador, guiñada | 4 | Variable | Enteros sin signo en [40, 220];
| | | | neutro = 128
| Comando especial | 1 | Variable | 0x00 normal, 0x01 despegue,
| | | | 0x02 aterrizaje/parada, 0x04
| | | | calibración, 0x05 cámara
| Modo sin cabeza | 1 | Variable | 0x02 off, 0x03 on; OR 0x08 activa
| | | | acrobacia en ambos bytes
| Relleno | 10 | Fijo | Ceros
| Checksum | 1 | Variable | XOR de los 6 bytes de control
| | | | anteriores
| Sufijo | 6 | Fijo | 0x00 0x00 0x14 0x00 0x66
| | | | 0x14
Checksum Prefijo fijo + contadores de secuencia | 14 | Variable | Tres contadores de 16 bits (ctr1,
| | | | ctr2, ctr3) que se incrementan
| | | | en cada envío
C2 | Contador ctr2 + sufijo fijo | 32 | Variable | Primeros 2 bytes: contador de
| | | | secuencia; resto fijo (C2_SUFFIX)
C3 | Contador ctr3 + sufijo fijo | 34 | Variable | Primeros 2 bytes: contador de
| | | | secuencia; resto fijo (C3_SUFFIX)
Total | | 124

predefinidos para ordenar el despegue automático, el aterrizaje, la calibración de la IMU interna del dron, el movimiento de la cámara o el inicio de una acrobacia, y un byte de modo sin cabeza (headless), que controla si el dron interpreta los ejes de traslación respecto a su propia orientación instantánea o respecto a la que tenía en el momento del despegue. Los bloques C2 y C3 repiten parte de la información de vuelo con campos de estado adicionales y cierran el datagrama con un sufijo de bytes de valor fijo que actúa como delimitador. La Tabla 7.3 recoge los valores del byte de comando especial identificados durante la captura y su significado.
Tabla 7.3. Valores del byte de comando especial en el bloque C1 del protocolo K417. Valor (hex) Constante en firmware Acción
0x00 | CMD_NONE | Ninguna (control normal)
0x01 | CMD_TAKEOFF | Despegue automático
0x02 | CMD_LAND | Aterrizaje suave
0x04 | CMD_CALIBRATE | Calibración de la IMU del dron
0x05 | CMD_STOP | Parar motores
0x08 | SOMERSAULT_FLAG | Activar modo acrobacia)

### 7.2. Bucle de control

La totalidad del procesamiento se ejecuta en el microcontrolador Arduino Nano RP2040 Connect sin intervención de ningún sistema externo. El bucle principal opera a dos cadencias independientes: los paquetes de control se envían al dron a 40 Hz y la telemetría de diagnóstico se emite por el puerto serie a 25 Hz, evitando así que la carga de comunicación serie interfiera con el lazo de vuelo. La Figura 7.1 ilustra el flujo completo de procesamiento en cada iteración.

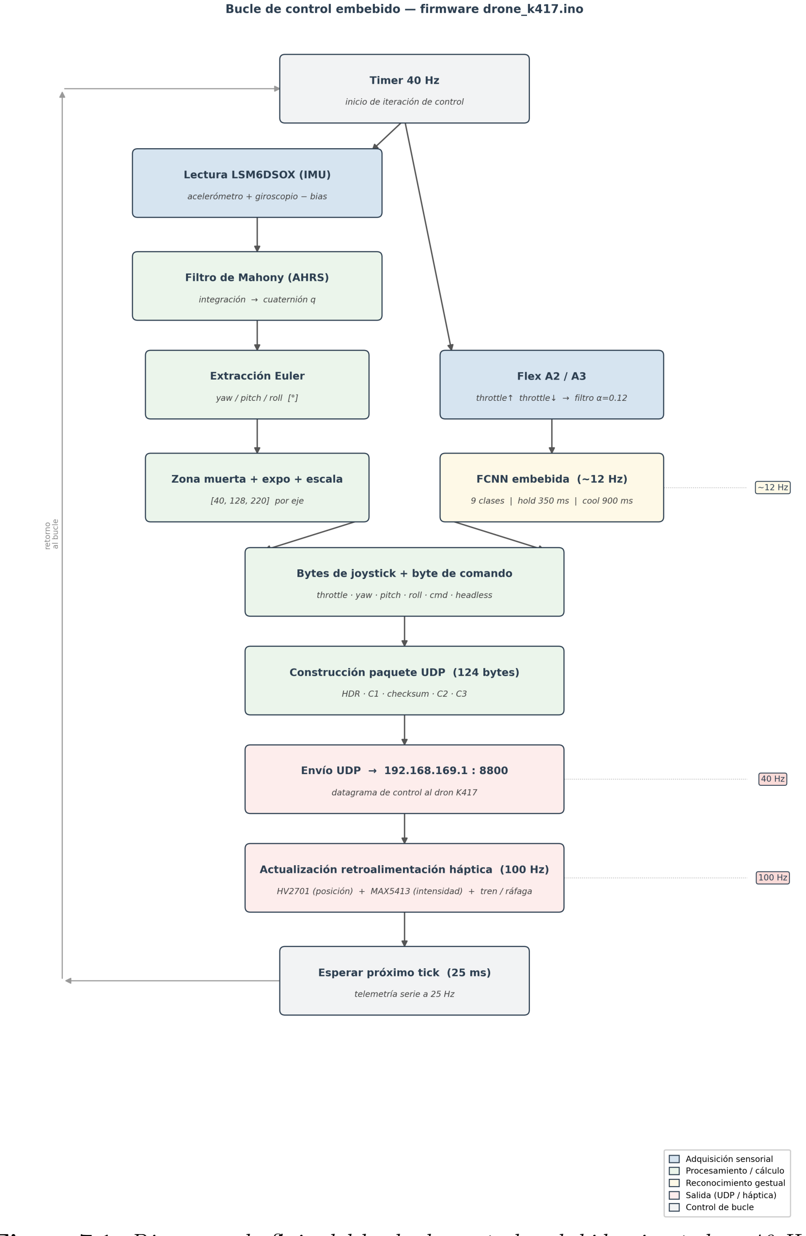
[picture p23: figure]

Figura 7.1. Diagrama de flujo del bucle de control embebido ejecutado a 40 Hz.

Estimación de orientación. Al inicio de cada iteración se leen las medidas de acelerómetro y giroscopio del sensor LSM6DSOX y se integran en el filtro de Mahony para actualizar el cuaternión de orientación. Durante la fase de calibración inicial, que comprende 200 muestras tomadas con el guante en reposo, se estiman y corrigen los sesgos de offset del giroscopio. El filtro opera con ganancia proporcional Kp = 3,5 y ganancia integral Ki = 0,03, valores que garantizan una convergencia rápida de la estimación frente a las perturbaciones de aceleración lineal que se producen durante el movimiento de la mano.

Mapeo de orientación a ejes de vuelo. A partir del cuaternión se extraen los ángulos de Euler de guiñada, cabeceo y alabeo. Antes de convertirlos en los bytes del joystick virtual se aplica sobre cada eje una cadena de acondicionamiento en tres etapas: una zona muerta de 8 que cancela las desviaciones de orientación menores para suprimir el temblor fisiológico de la mano; una función de exposición no lineal que suaviza la respuesta en torno al punto neutro y la amplifica en los extremos del recorrido; y un escalado lineal que convierte el ángulo resultante, acotado a un máximo de 45, al rango entero [40, 220] con 128 como valor neutro.

Control del acelerador mediante sensores de flexión. El canal de acelerador no se deriva de la orientación de la mano sino de dos sensores de flexión dedicados, conectados a las entradas analógicas A2 (gas positivo) y A3 (gas negativo). La diferencia entre sus lecturas normalizadas, calculada respecto a la media y desviación típica registradas durante la calibración, se filtra mediante un promedio exponencial de primer orden con coeficiente α = 0,12 para eliminar transitorios bruscos y se mapea al mismo rango
[40, 220].

Reconocimiento gestual y comandos discretos. La red neuronal fully-connected embebida procesa a aproximadamente 12 Hz las lecturas normalizadas de los cuatro sensores de flexión y produce una estimación de la clase gestual activa entre nueve posibles. Para reducir la tasa de falsos positivos, el firmware exige que la clase predicha se mantenga estable durante al menos 350 ms y que el margen de confianza supere un umbral mínimo antes de activar el comando de vuelo asociado. Una vez disparado un comando, se impone un período de bloqueo de 900 ms durante el cual no puede activarse ninguna acción nueva. La Tabla 7.4 relaciona las clases gestuales con los comandos de vuelo y el patrón de retroalimentación háptica emitido como confirmación.

### 7.3. Secuencia de acrobacia

La maniobra de acrobacia merece una descripción específica por su mayor complejidad temporal. Cuando el gesto correspondiente supera los umbrales de estabilidad y confianza, el firmware congela los valores actuales de los cuatro ejes de vuelo y entra en una máquina de estados de dos fases. Durante la primera fase, denominada de impulso, se envían 20 paquetes consecutivos con el indicador de acrobacia activado en el byte de comando y el acelerador forzado a 212 sobre el máximo de 220, con el fin de dotar al dron del empuje necesario para completar el giro. Superado ese bloque de paquetes, se entra en la fase de recuperación, en la que se envían 10 paquetes adicionales con el acelerador reducido a 204 para estabilizar el vuelo antes de devolver el control al lazo normal. Durante las dos

Tabla 7.4. Correspondencia entre clase gestual, comando de vuelo y retroalimentación háptica de confirmación.
Clase Comando de vuelo | Zona háptica | Modo
0 | Reposo (sin acción) | — | —
1 | Despegue automático | Palma (M20) | Ráfaga ×1
2 | Aterrizaje suave | Palma (M20) | Ráfaga ×1
3 | Parada de emergencia | Palma (M20) | Ráfaga ×3
4 | Calibración IMU dron | Índice (M8) | Ráfaga ×1
5 | Activar/desactivar modo headless Pulgar (M4) | Ráfaga ×1
6 | Elevar cámara | Índice (M8) | Ráfaga ×1
7 | Acrobacia (flip) | Medio-anular (M12) Ráfaga ×3
8 | Modo acrobacia latente | — | —

fases, los ejes de traslación permanecen congelados en los valores previos para impedir que movimientos involuntarios de la mano generen comandos espurios durante la maniobra.

### 7.4. Retroalimentación háptica durante el vuelo

La retroalimentación háptica cierra el lazo sensoriomotor informando al piloto, a través de la estimulación electrotáctil, sobre el estado de cada uno de los ejes de vuelo que está generando con la mano. El principio de diseño adoptado establece una correspondencia unívoca entre eje de control y zona anatómica, de modo que el piloto puede distinguir táctilmente qué canal está activo sin necesidad de apartar la vista del dron. La Tabla 7.5 resume esta correspondencia junto con los parámetros de estimulación empleados en cada canal, y la Figura 7.2 ilustra la distribución de las zonas sobre el dorso de la mano.
Tabla 7.5. Correspondencia entre eje de vuelo, zona anatómica y parámetros del canal háptico.
Eje de vuelo | Zona anatómica | Posición HV2701 Pot. mín. Pot. máx.
Guiñada (yaw) | Región del pulgar | M4 (canal 2) | 16 | 25
Cabeceo (pitch) | Región del índice | M8 (canal 3) | 23 | 28
Alabeo (roll) | Región medio-anular M12 (canal 4) | 28 | 35
Acelerador (throttle) Región de la palma M20 (canal 10) | 14 | 20

El sistema de retroalimentación opera a una cadencia de actualización de 100 Hz. En cada ciclo el firmware normaliza el valor de cada eje al rango [0, 1] y evalúa si supera el umbral neutro. Si al menos uno de los cuatro ejes está activo, se selecciona mediante un esquema de turno rotatorio el canal correspondiente: se escribe la palabra de 16 bits de la posición elegida en el HV2701 para conectar los electrodos de esa zona, se ajusta el potenciómetro digital MAX5413 al valor de intensidad asignado a ese canal y se lanza un tren de pulsos de 100 Hz con una anchura de pulso de 400 µs y una duración de 2 s. El esquema rotatorio garantiza que ningún canal monopolice el hardware de estimulación cuando varios ejes están activos de forma simultánea. Si todos los ejes vuelven a la posición neutra, la estimulación se detiene inmediatamente.
Para los comandos discretos generados por reconocimiento gestual se emplea una modalidad diferente: una ráfaga corta de pulsos en la zona anatómica asociada al gesto activado, cuyo número varía según la relevancia del comando. Una ráfaga de un pulso confirma comandos habituales como el despegue o el aterrizaje, mientras que una ráfaga de tres pulsos se reserva para maniobras de mayor impacto, como la parada de emergencia

[FIGURA: Dorso de la mano con las cuatro zonas de estimulación
electrotáctil señaladas:
pulgar ↔ yaw, índice ↔ pitch, medio-anular ↔ roll, palma ↔ throttle.]

Figura 7.2. Distribución de las cuatro zonas de retroalimentación háptica sobre el dorso de la mano para el control del dron.

o la acrobacia, lo que permite al piloto distinguirlas táctilmente sin ambigüedad. Durante el tiempo que dura la ráfaga, un temporizador de bloqueo impide que el canal de retroalimentación continua se active, evitando solapamientos entre los dos modos de estimulación. Por último, durante la ejecución de la secuencia de acrobacia, toda la retroalimentación háptica se suspende de forma completa, dado que los ejes de control se encuentran artificialmente congelados y cualquier estímulo generado en ese instante carecería de correlación con el estado real del vuelo.
Tabla 7.6. Desglose de tiempos de ejecución de un ciclo completo de programa.
| IMU (Lectura y Filtro) | ADC | Red Neuronal | Lógica CPU | Envío WiFi | Hápticos | Otros | TOTAL
Tiempo (ms) | 3.494 | 0.083 | 1.415 | 0.212 | 2.115 | 0.403 | 0.039 | 6.880

## 8 Conclusiones y trabajo futuro

Se acabo el master

## Bibliografía

[1] Jorge Cuartero Galindo. Inteligencia artificial sobre procesadores edge computing. Trabajo fin de grado en Física, Universidad de Zaragoza, 2024.
[2] Y. Tanaka, A. Shen, A. Kong, and P. Lopes. Full-hand electro-tactile feedback
without obstructing palmar side of hand. Proceedings of the 2023 CHI Conference
on Human Factors in Computing Systems (pp. 1-15), 2023.
[3] Arduino Nano RP2040 Conncect. URL: https://docs.arduino.cc/hardware/nano-rp2040-connect/.
[4] Módulo LSM6DSOX. URL: https://www.st.com/en/mems-and-sensors/lsm6dsox.html.
[5] Librería LSM6DSOX. URL: https://github.com/arduino-libraries/Arduino_LSM6DSOX.
[6] NINA-W102. URL: https://www.u-blox.com/en/product/nina-w10-series-open-cpu.
[7] Flex-Sensor. URL: https://www.spectrasymbol.com/resistive-flex-sensors/spectraflex-flex-sensors.
[8] Robert Mahony, Tarek Hamel, and Jean-Michel Pflimlin. Nonlinear complementary
filters on the special orthogonal group. IEEE Transactions on Automatic Control,
2008.
[9] TensorFlow. URL: https://www.tensorflow.org/?hl=es.
[10] One-hot encoding. URL: https://medium.com/thedeephub/one-hot-encoding-with-tensorflowand-keras-569cfa91b162.
[11] TensorFlow Lite. URL: https://www.tensorflow.org/lite/.
[12] Librería eloquentarduino. URL: https://github.com/eloquentarduino.

## Anexos

## A Repositorio de Git-Hub

Nam dui ligula, fringilla a, euismod sodales, sollicitudin vel, wisi. Morbi auctor lorem non justo. Nam lacus libero, pretium at, lobortis vitae, ultricies et, tellus. Donec aliquet, tortor sed accumsan bibendum, erat ligula aliquet magna, vitae ornare odio metus a mi. Morbi ac orci et nisl hendrerit mollis. Suspendisse ut massa. Cras nec ante. Pellentesque a nulla. Cum sociis natoque penatibus et magnis dis parturient montes, nascetur ridiculus mus. Aliquam tincidunt urna. Nulla ullamcorper vestibulum turpis. Pellentesque cursus luctus mauris.

i

## B GUI de control del dron

Nulla malesuada porttitor diam. Donec felis erat, congue non, volutpat at, tincidunt tristique, libero. Vivamus viverra fermentum felis. Donec nonummy pellentesque ante. Phasellus adipiscing semper elit. Proin fermentum massa ac quam. Sed diam turpis, molestie vitae, placerat a, molestie nec, leo. Maecenas lacinia. Nam ipsum ligula, eleifend at, accumsan nec, suscipit a, ipsum. Morbi blandit ligula feugiat magna. Nunc eleifend consequat lorem. Sed lacinia nulla vitae enim. Pellentesque tincidunt purus vel magna. Integer non enim. Praesent euismod nunc eu purus. Donec bibendum quam in tellus. Nullam cursus pulvinar lectus. Donec et mi. Nam vulputate metus eu enim. Vestibulum pellentesque felis eu massa.

ii
