unax4/Haptic-stimulation-and-drone-control/(commit log)

2026-06-09 Remove build artifacts and camera tools from public repo
2026-06-09 Refresh root readme for current repo layout
